electricboy6/STM32U585-devboard/pcb/AT25SF041B-SSHB-B/3D/AT25SF041B-SSHB-B.stp

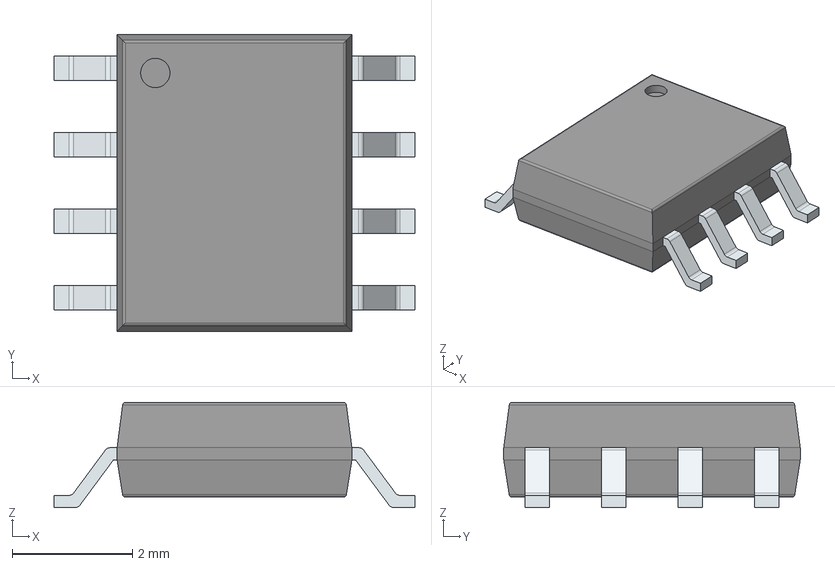
[picture p1: CAD file, 2025-12-07]
pcb/AT25SF041B-SSHB-B/3D/AT25SF041B-SSHB-B.stp
6.00 x 4.92 x 1.75 mm
PinsArrayLR
