electricboy6/STM32U585-devboard/pcb/BLM15AX102SN1D/3D/BLM15AX102SN1D.stp

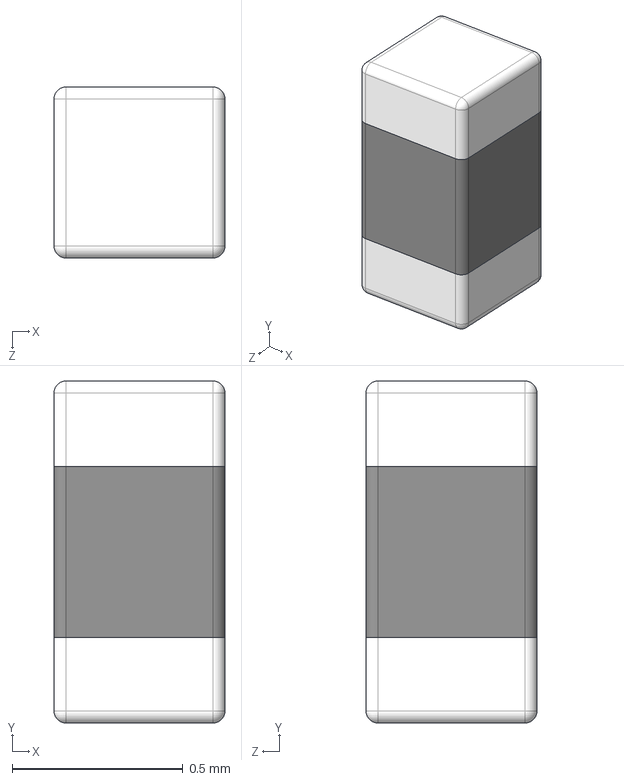
[picture p2: CAD file, 2025-11-30]
pcb/BLM15AX102SN1D/3D/BLM15AX102SN1D.stp
0.5 x 1.00 x 0.5 mm
