electricboy6/STM32U585-devboard/pcb/BMP581/3D/BMP581.stp

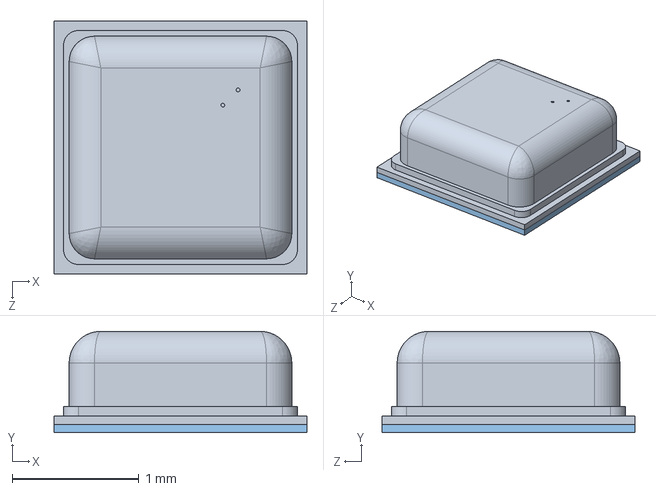
[picture p3: CAD file, 2025-10-23]
pcb/BMP581/3D/BMP581.stp
2.00 x 0.801 x 2.00 mm
