electricboy6/STM32U585-devboard/pcb/CM7V-T1A-32.768KHZ-9PF-10PPM-TA-QC/3D/CM7V-T1A-32.768KHZ-9PF-10PPM-TA-QC.stp

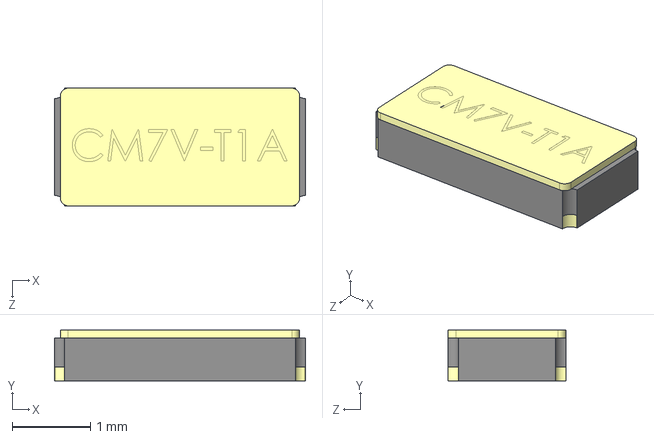
[picture p4: CAD file, 2025-11-30]
pcb/CM7V-T1A-32.768KHZ-9PF-10PPM-TA-QC/3D/CM7V-T1A-32.768KHZ-9PF-10PPM-TA-QC.stp
3.20 x 0.65 x 1.50 mm
