electricboy6/STM32U585-devboard/pcb/ECS-160-8-36B2-CKM-TR/3D/ECS-160-8-36B2-CKM-TR.stp

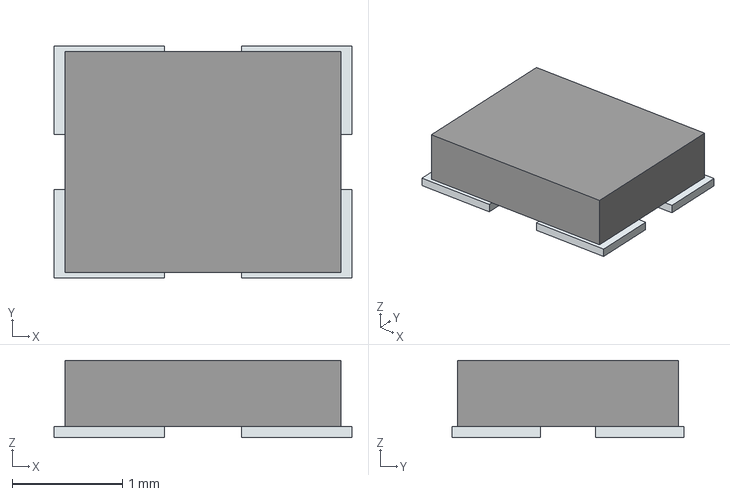
[picture p5: CAD file, 2025-11-26]
pcb/ECS-160-8-36B2-CKM-TR/3D/ECS-160-8-36B2-CKM-TR.stp
2.70 x 2.10 x 0.7 mm
Pins
