electricboy6/STM32U585-devboard/pcb/ECS-TXO-25CSMV-320-AM-TR/3D/ECS-TXO-25CSMV-320-AM-TR.stp

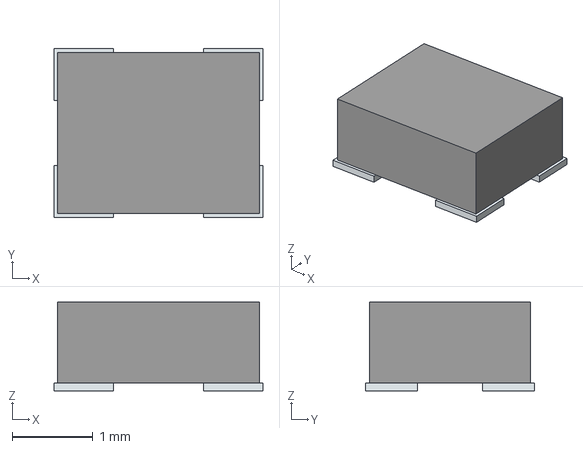
[picture p6: CAD file, 2025-11-10]
pcb/ECS-TXO-25CSMV-320-AM-TR/3D/ECS-TXO-25CSMV-320-AM-TR.stp
2.59 x 2.09 x 1.10 mm
Pins
