electricboy6/STM32U585-devboard/pcb/H3LIS331DLTR/H3LIS331DLTR.step

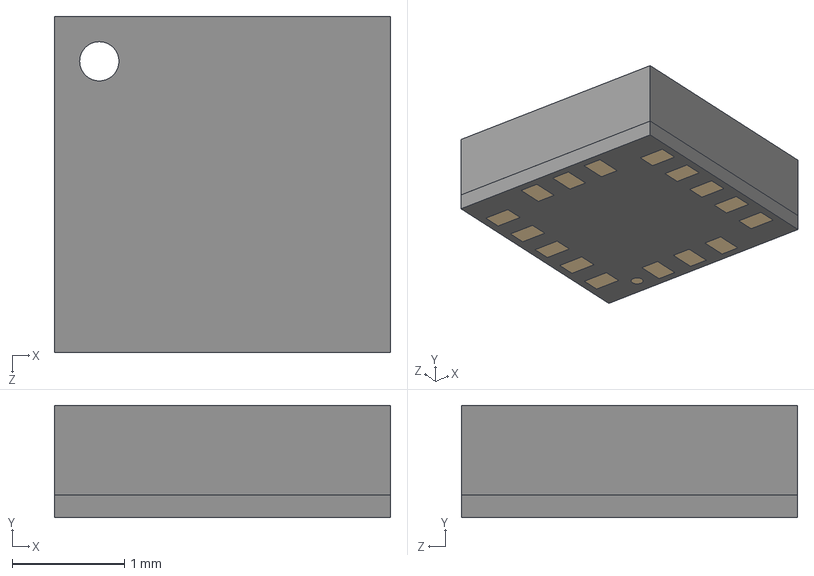
[picture p7: CAD file, 2025-12-19]
pcb/H3LIS331DLTR/H3LIS331DLTR.step
3.00 x 1.00 x 3.00 mm
