electricboy6/STM32U585-devboard/pcb/ICM-42670-P/3D/ICM-42670-P.stp

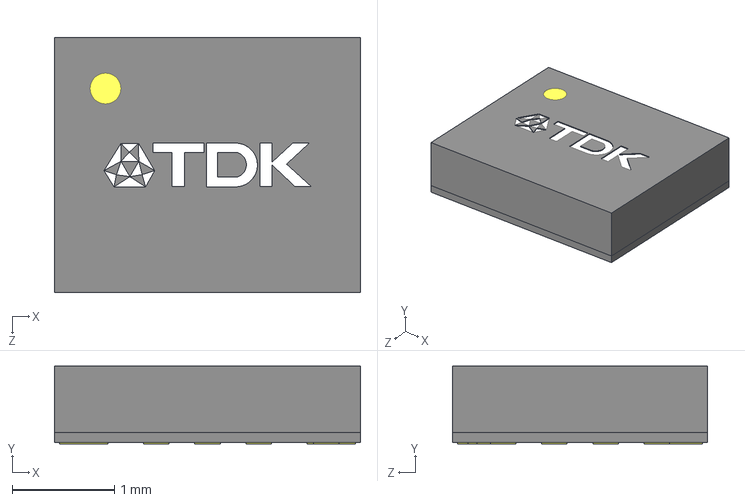
[picture p8: CAD file, 2025-10-23]
pcb/ICM-42670-P/3D/ICM-42670-P.stp
3.00 x 0.76 x 2.50 mm
