electricboy6/STM32U585-devboard/pcb/IRFR9014PBF/3D/IRFR9014PBF.stp

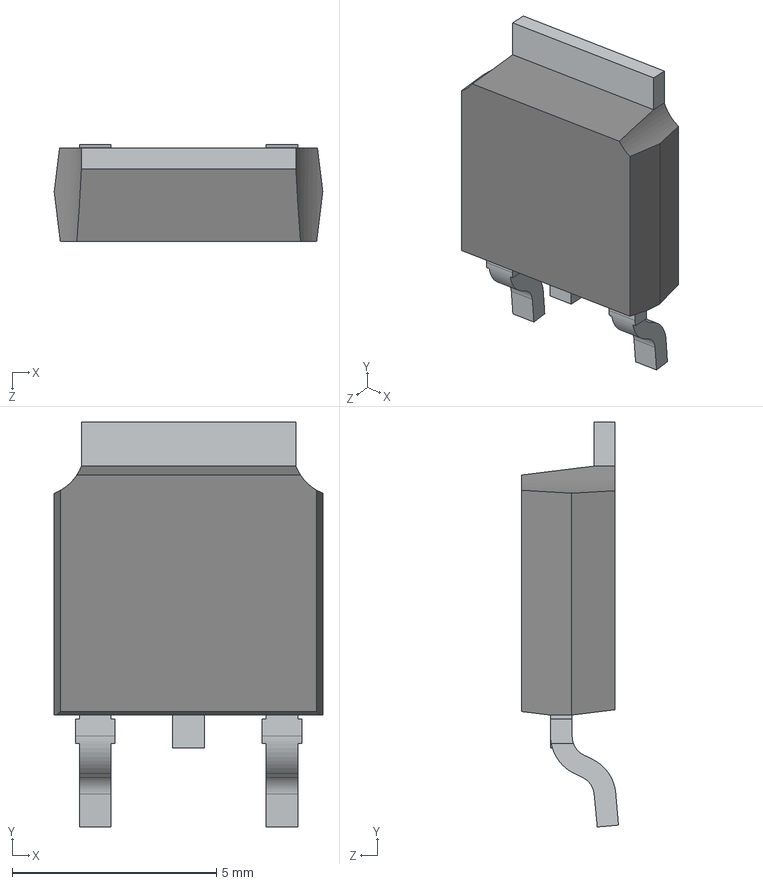
[picture p9: CAD file, 2025-11-10]
pcb/IRFR9014PBF/3D/IRFR9014PBF.stp
6.58 x 9.92 x 2.38 mm
