electricboy6/STM32U585-devboard/pcb/MMC5983MA/3D/MMC5983MA.stp

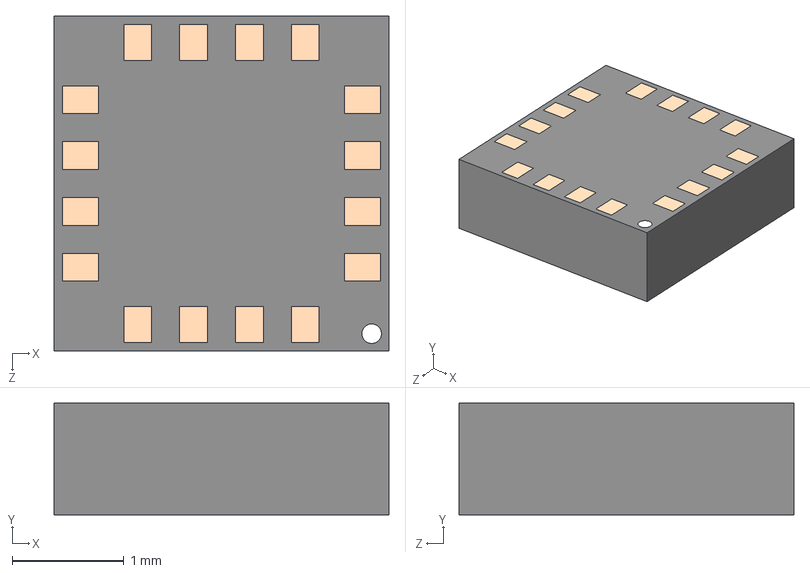
[picture p10: CAD file, 2025-11-10]
pcb/MMC5983MA/3D/MMC5983MA.stp
3.00 x 1.00 x 3.00 mm
