electricboy6/STM32U585-devboard/pcb/MPM3610GQV-Z/3D/MPM3610GQV-Z.stp

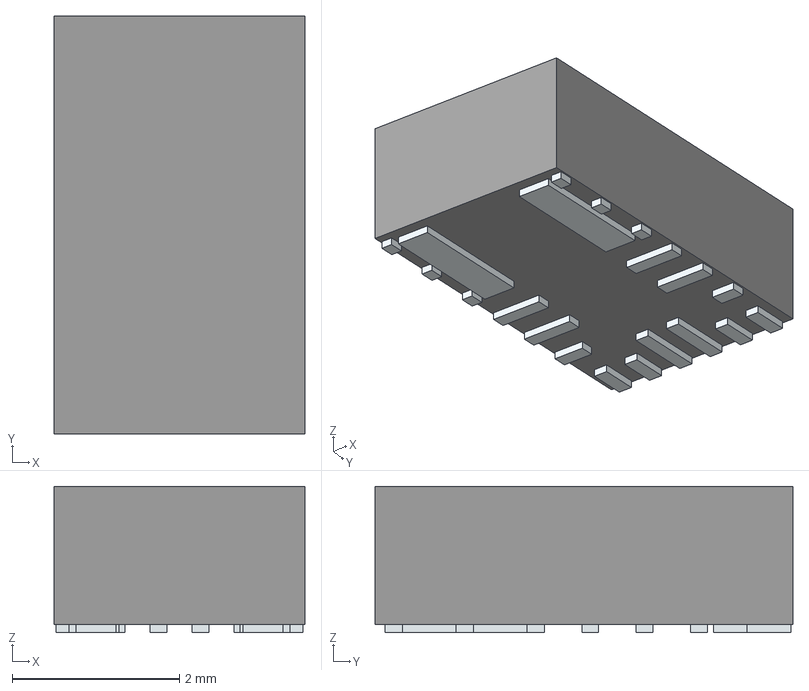
[picture p11: CAD file, 2025-10-26]
pcb/MPM3610GQV-Z/3D/MPM3610GQV-Z.stp
3.00 x 5.00 x 1.75 mm
Pins
