electricboy6/STM32U585-devboard/pcb/partsLibs/TBC05-02-1-G-G/3D/TBC05-02-1-G-G.stp

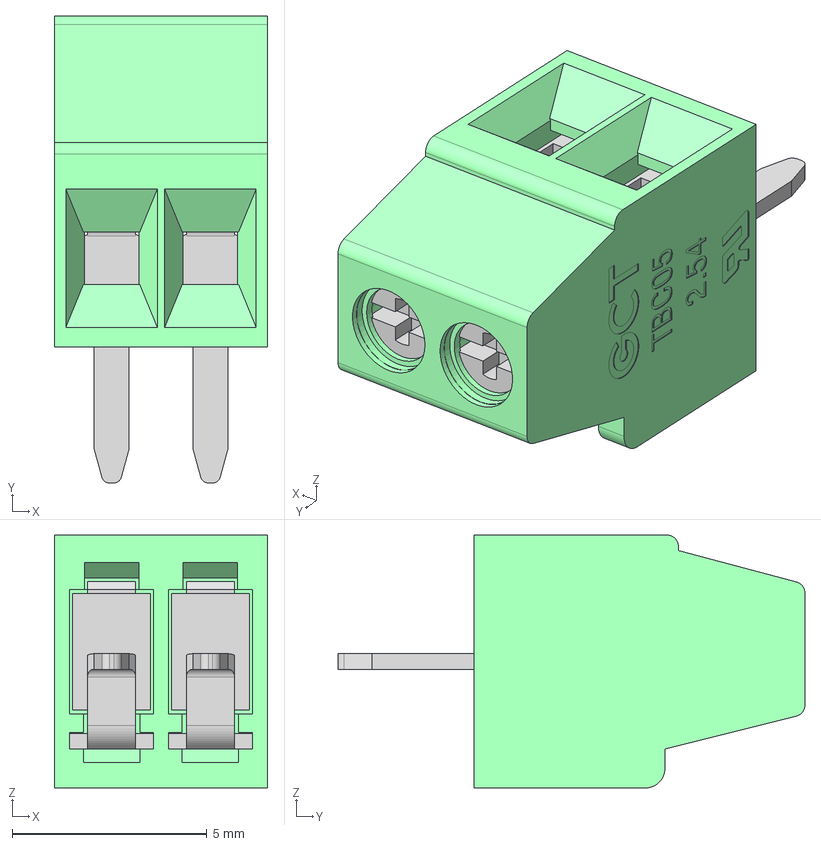
[picture p12: CAD file, 2025-12-23]
pcb/partsLibs/TBC05-02-1-G-G/3D/TBC05-02-1-G-G.stp
5.48 x 12.0 x 6.50 mm
TBC05-02-1-G-G_H
TBC05-02-1-G-G_P x 2
