electricboy6/STM32U585-devboard/pcb/partsLibs/TBC05-04-1-G-G/3D/TBC05-04-1-G-G.stp

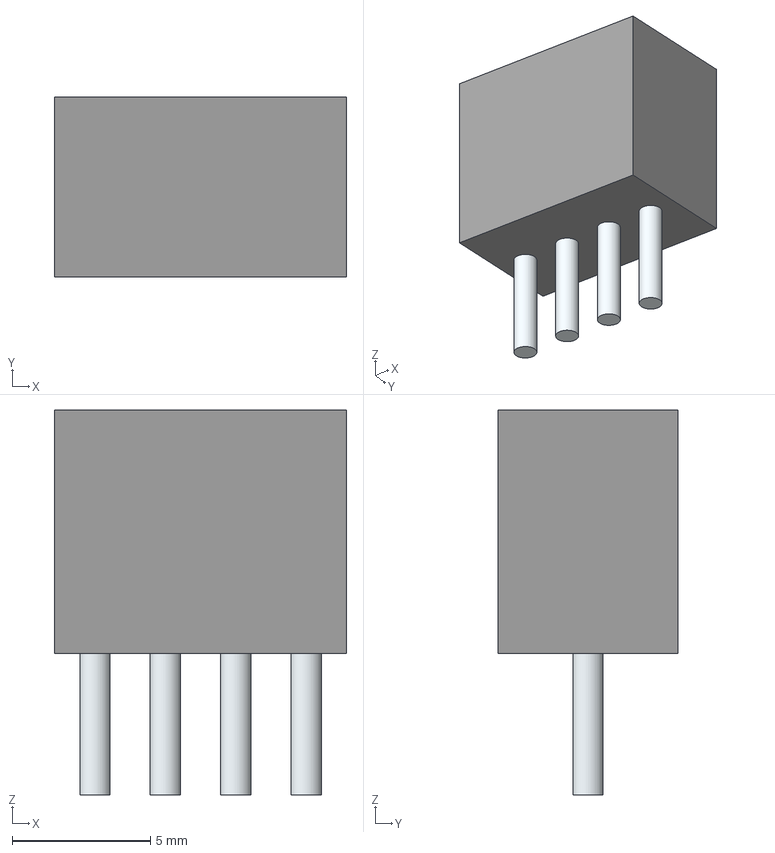
[picture p13: CAD file, 2025-12-23]
pcb/partsLibs/TBC05-04-1-G-G/3D/TBC05-04-1-G-G.stp
10.6 x 6.50 x 13.9 mm
Leads
