electricboy6/STM32U585-devboard/pcb/partsLibs/TBC05-06-1-G-G/3D/TBC05-06-1-G-G.stp

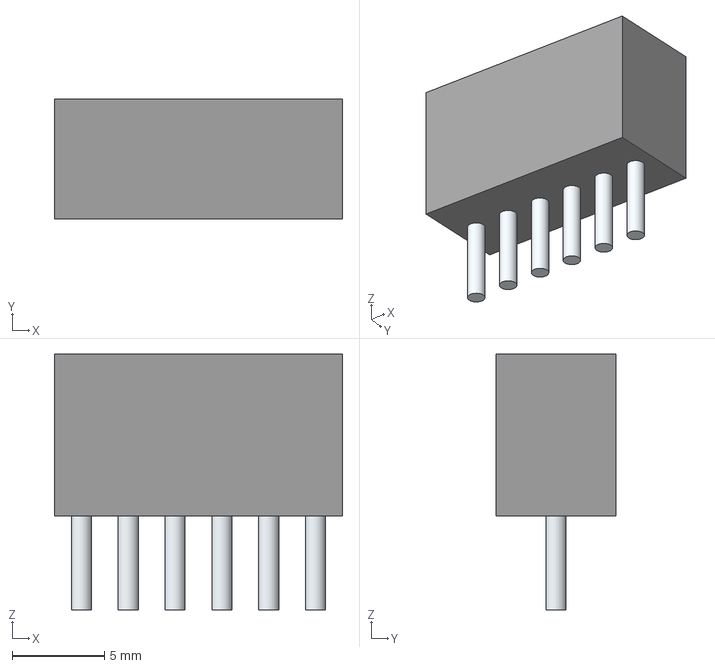
[picture p14: CAD file, 2025-12-23]
pcb/partsLibs/TBC05-06-1-G-G/3D/TBC05-06-1-G-G.stp
15.6 x 6.50 x 13.9 mm
Leads
