electricboy6/STM32U585-devboard/pcb/PS1240P02BT/3D/PS1240P02BT.stp

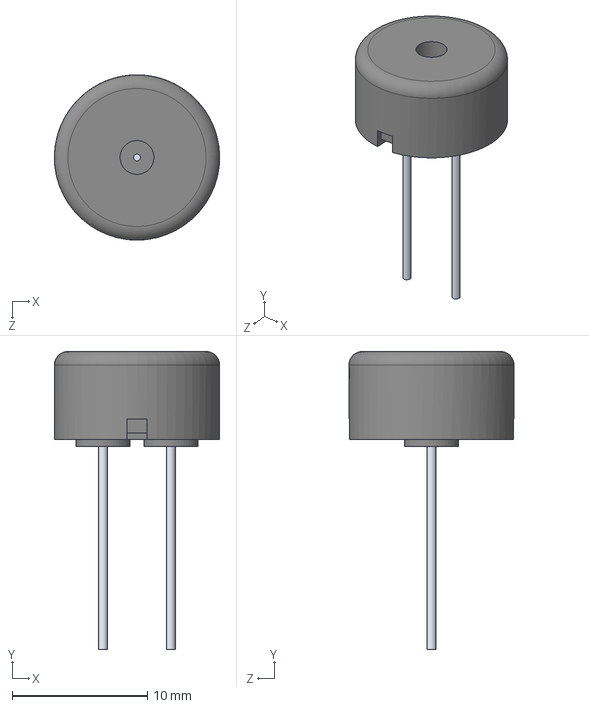
[picture p15: CAD file, 2025-12-08]
pcb/PS1240P02BT/3D/PS1240P02BT.stp
12.2 x 22.0 x 12.2 mm
