electricboy6/STM32U585-devboard/pcb/3dmodels/tbc05-06-1-g-g.stp

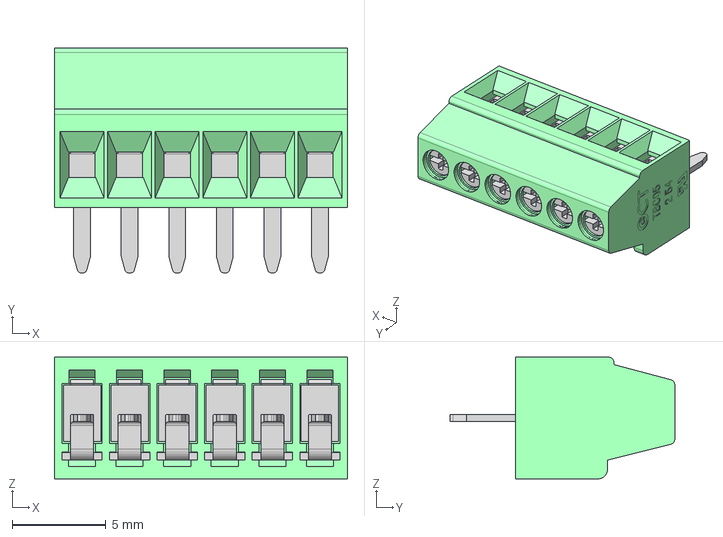
[picture p17: CAD file, 2025-12-27]
pcb/3dmodels/tbc05-06-1-g-g.stp
15.6 x 12.0 x 6.50 mm
