electricboy6/STM32U585-devboard/pcb/3dmodels/stm32u073.step

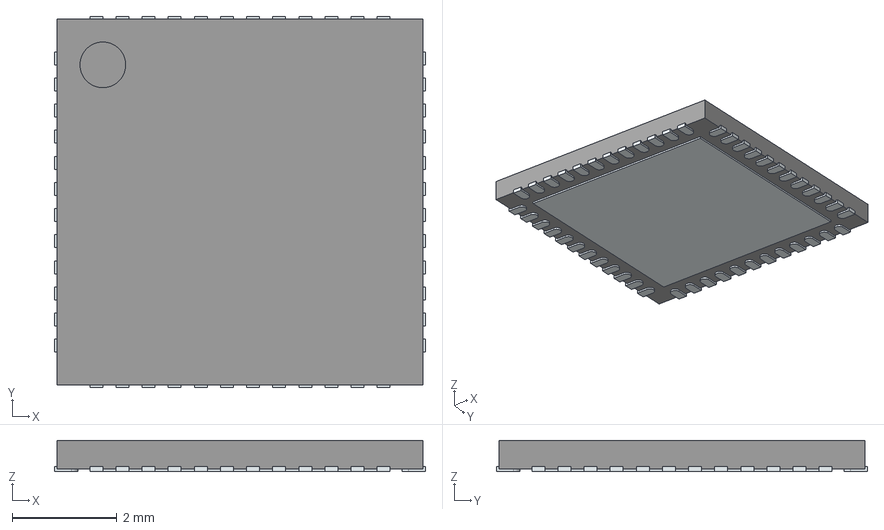
[picture p18: CAD file, 2025-12-21]
pcb/3dmodels/stm32u073.step
7.10 x 7.10 x 0.6 mm
ThermalPin
PinsArrayLR
PinsArrayTB
