electricboy6/STM32U585-devboard/pcb/3dmodels/MAX-M10S-00B.STEP

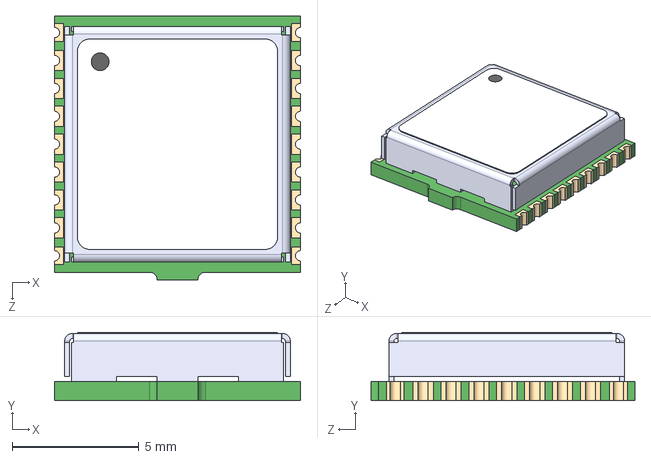
[picture p19: CAD file, 2025-12-21]
pcb/3dmodels/MAX-M10S-00B.STEP
9.70 x 2.70 x 10.4 mm
