electricboy6/STM32U585-devboard/pcb/3dmodels/stm32u585.step

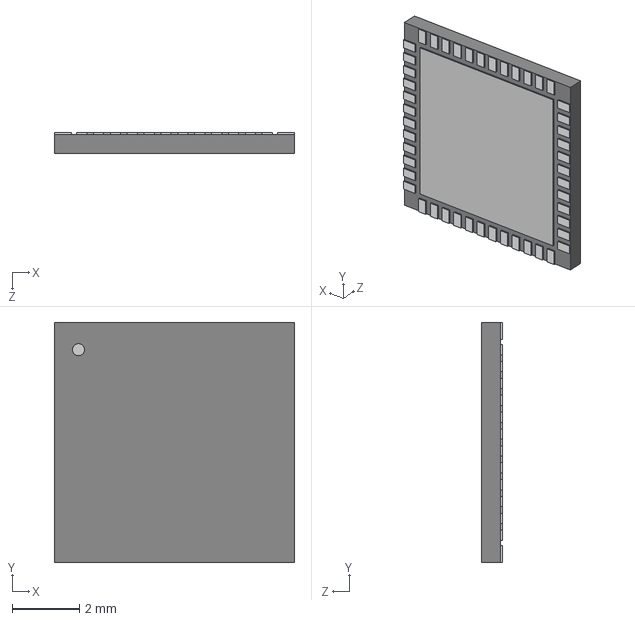
[picture p20: CAD file, 2025-12-21]
pcb/3dmodels/stm32u585.step
7.11 x 7.11 x 0.612 mm
