electricboy6/STM32U585-devboard/(list of files, cad)

Other CAD files:
pcb/3dmodels/1040310811.stp
pcb/73412-0114/3D/73412-0114.stp
