electricboy6/STM32U585-devboard/pcb/stDevboard.kicad_pcb

## KiCad design pcb/stDevboard.kicad_pcb (2026-01-02)

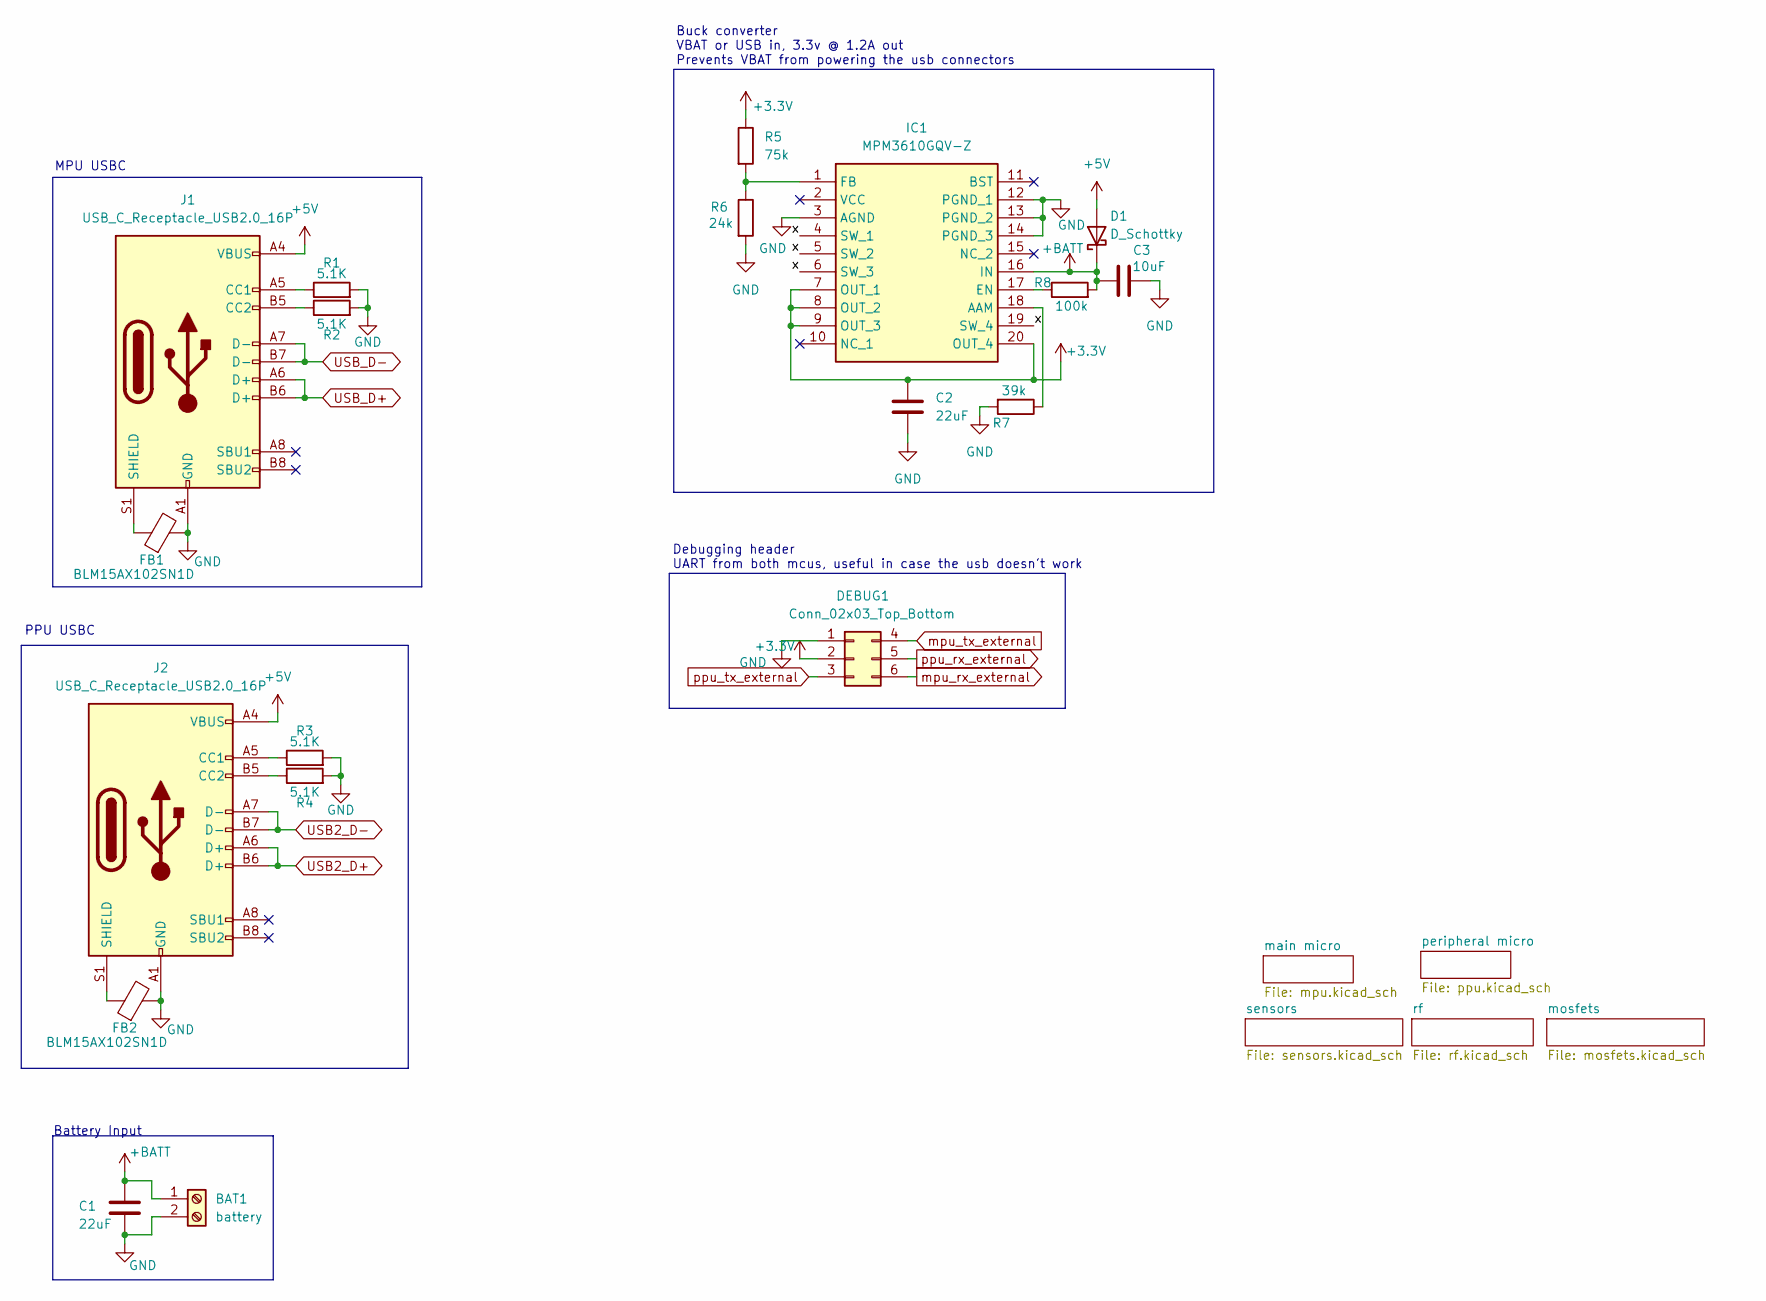
[picture p21: schematic stDevboard.kicad_sch]

Parts:
BAT1: battery; TBC05021GG
C1, C2: 22uF; C_0603_1608Metric
C3: 10uF; C_0603_1608Metric
D1: D_Schottky; D_SOD-123
DEBUG1: Conn_02x03_Top_Bottom; PinHeader_2x03_P2.54mm_Vertical
FB1, FB2: BLM15AX102SN1D; NFZ15SG152SN10B
IC1: MPM3610GQV-Z; MPM3606GQVZ; Mouser Part Number 946-MPM3610GQV-Z
J1, J2: USB_C_Receptacle_USB2.0_16P; USB_C_Receptacle_GCT_USB4085
R1, R2, R3, R4: 5.1K; R_0402_1005Metric
R5: 75k; R_0402_1005Metric
R6: 24k; R_0402_1005Metric
R7: 39k; R_0402_1005Metric
R8: 100k; R_0402_1005Metric

Connections:
+5V: D1.2 (A), J1.A4 (VBUS), J1.A9 (VBUS), J1.B4 (VBUS), J1.B9 (VBUS), J2.A4 (VBUS), J2.A9 (VBUS), J2.B4 (VBUS), J2.B9 (VBUS)
+BATT: BAT1.1, C1.1, C3.1, D1.1 (K), IC1.16 (IN), R8.2; also elsewhere on the board
/x: IC1.4 (SW_1), IC1.5 (SW_2), IC1.6 (SW_3), IC1.19 (SW_4)
GND: BAT1.2, C1.2, C2.1, C3.2, DEBUG1.1, FB1.2, FB2.2, IC1.3 (AGND), IC1.12 (PGND_1), IC1.13 (PGND_2), IC1.14 (PGND_3), J1.A1 (GND), J1.A12 (GND), J1.B1 (GND), J1.B12 (GND), J2.A1 (GND), J2.A12 (GND), J2.B1 (GND), J2.B12 (GND), R1.2, R2.2, R3.2, R4.2, R6.2, R7.2; also elsewhere on the board
unnamed: IC1.18 (AAM), R7.1
unnamed: IC1.17 (EN), R8.1
unnamed: IC1.1 (FB), R5.2, R6.1
unnamed: J1.A5 (CC1), R1.1
unnamed: J1.B5 (CC2), R2.1
unnamed: FB1.1, J1.S1 (SHIELD)
unnamed: J2.A5 (CC1), R3.1
unnamed: J2.B5 (CC2), R4.1
unnamed: FB2.1, J2.S1 (SHIELD)
USB2_D+: J2.A6 (D+), J2.B6 (D+); also elsewhere on the board
USB2_D-: J2.A7 (D-), J2.B7 (D-); also elsewhere on the board
USB_D+: J1.A6 (D+), J1.B6 (D+); also elsewhere on the board
USB_D-: J1.A7 (D-), J1.B7 (D-); also elsewhere on the board
mpu_rx_external: DEBUG1.6; also elsewhere on the board
mpu_tx_external: DEBUG1.4; also elsewhere on the board
ppu_rx_external: DEBUG1.5; also elsewhere on the board
ppu_tx_external: DEBUG1.3; also elsewhere on the board

Notes on the sheet:
Debugging header UART from both mcus, useful in case the usb doesn't work
Buck converter VBAT or USB in, 3.3v @ 1.2A out Prevents VBAT from powering the usb connectors
MPU USBC
PPU USBC
Battery Input

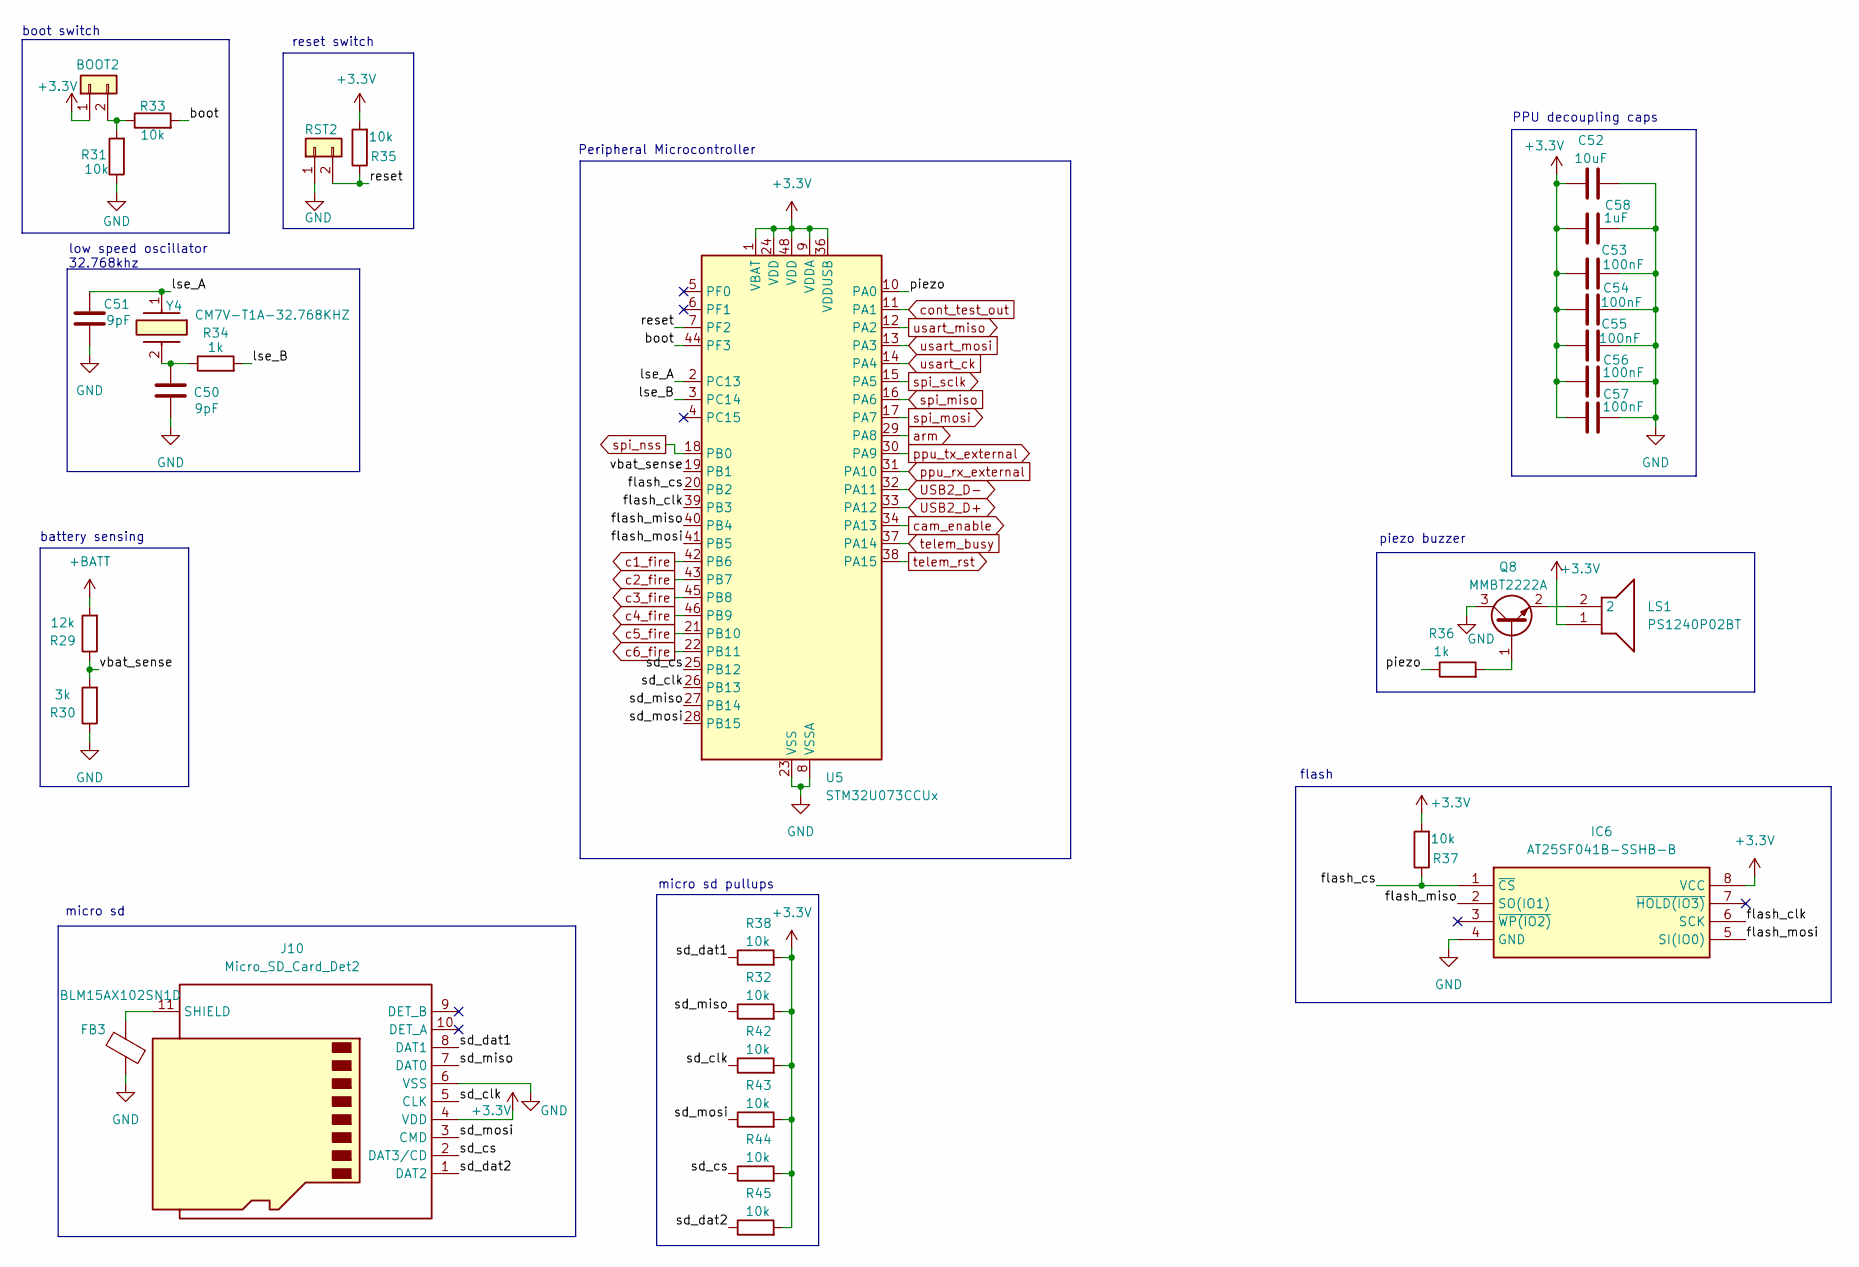
[picture p22: schematic ppu.kicad_sch]

Parts:
BOOT2: Conn_01x02; PinHeader_1x02_P2.54mm_Vertical
C50, C51: 9pF; C_0402_1005Metric
C52: 10uF; C_0603_1608Metric
C53, C54, C55, C56, C57: 100nF; C_0402_1005Metric
C58: 1uF; C_0603_1608Metric
FB3: BLM15AX102SN1D; NFZ15SG152SN10B
IC6: AT25SF041B-SSHB-B; SOIC127P600X175-8N; Mouser Part Number 988-AT25SF041-SSH-B
J10: Micro_SD_Card_Det2; microSD_HC_Molex_104031-0811
LS1: PS1240P02BT; Mouser Part Number 810-PS1240P02BT
Q8: MMBT2222A; SOT-23
R29: 12k; R_0402_1005Metric
R30: 3k; R_0402_1005Metric
R31, R32, R33, R35, R37, R38, R42, R43, R44, R45: 10k; R_0402_1005Metric
R34, R36: 1k; R_0402_1005Metric
RST2: Conn_01x02; PinHeader_1x02_P2.54mm_Vertical
U5: STM32U073CCUx; QFN-48-1EP_7x7mm_P0.5mm_EP5.6x5.6mm
Y4: CM7V-T1A-32.768KHZ; CM7V32768TBQA020; Mouser Part Number 428-201565-MG01

Connections:
+BATT: R29.2; also elsewhere on the board
/peripheral micro/boot: R33.2, U5.44 (PF3)
/peripheral micro/flash_clk: IC6.6 (SCK), U5.39 (PB3)
/peripheral micro/flash_cs: IC6.1 (~CS), R37.1, U5.20 (PB2)
/peripheral micro/flash_miso: IC6.2 (SO(IO1)), U5.40 (PB4)
/peripheral micro/flash_mosi: IC6.5 (SI(IO0)), U5.41 (PB5)
/peripheral micro/lse_A: C51.1, U5.2 (PC13), Y4.1
/peripheral micro/lse_B: R34.2, U5.3 (PC14)
/peripheral micro/piezo: R36.1, U5.10 (PA0)
/peripheral micro/reset: R35.1, RST2.2, U5.7 (PF2)
/peripheral micro/sd_clk: J10.5 (CLK), R42.1, U5.26 (PB13)
/peripheral micro/sd_dat1: J10.8 (DAT1), R38.1
/peripheral micro/sd_dat2: J10.1 (DAT2), R45.1
/peripheral micro/sd_mosi: J10.3 (CMD), R43.1, U5.28 (PB15)
/peripheral micro/vbat_sense: R29.1, R30.2, U5.19 (PB1)
GND: C50.2, C51.2, C52.2, C53.2, C54.1, C55.1, C56.1, C57.2, C58.2, FB3.1, IC6.4 (GND), J10.6 (VSS), Q8.3 (C), R30.1, R31.1, RST2.1, U5.8 (VSSA), U5.23 (VSS), U5.35 (VSS), U5.47 (VSS), U5.49 (VSS); also elsewhere on the board
unnamed: BOOT2.2, R31.2, R33.1
unnamed: C50.1, R34.1, Y4.2
unnamed: FB3.2, J10.11 (SHIELD)
unnamed: Q8.1 (B), R36.2
unnamed: LS1.2, Q8.2 (E)
USB2_D+: U5.33 (PA12); also elsewhere on the board
USB2_D-: U5.32 (PA11); also elsewhere on the board
arm: U5.29 (PA8); also elsewhere on the board
c1_fire: U5.42 (PB6); also elsewhere on the board
c2_fire: U5.43 (PB7); also elsewhere on the board
c3_fire: U5.45 (PB8); also elsewhere on the board
c4_fire: U5.46 (PB9); also elsewhere on the board
c5_fire: U5.21 (PB10); also elsewhere on the board
c6_fire: U5.22 (PB11); also elsewhere on the board
cam_enable: U5.34 (PA13); also elsewhere on the board
cont_test_out: U5.11 (PA1); also elsewhere on the board
ppu_rx_external: U5.31 (PA10); also elsewhere on the board
ppu_tx_external: U5.30 (PA9); also elsewhere on the board
spi_miso: U5.16 (PA6); also elsewhere on the board
spi_mosi: U5.17 (PA7); also elsewhere on the board
spi_nss: U5.18 (PB0); also elsewhere on the board
spi_sclk: U5.15 (PA5); also elsewhere on the board
telem_busy: U5.37 (PA14); also elsewhere on the board
telem_rst: U5.38 (PA15); also elsewhere on the board
usart_ck: U5.14 (PA4); also elsewhere on the board
usart_miso: U5.12 (PA2); also elsewhere on the board
usart_mosi: U5.13 (PA3); also elsewhere on the board

Notes on the sheet:
flash
PPU decoupling caps
reset switch
battery sensing
Peripheral Microcontroller
boot switch
micro sd
piezo buzzer
low speed oscillator 32.768khz
micro sd pullups

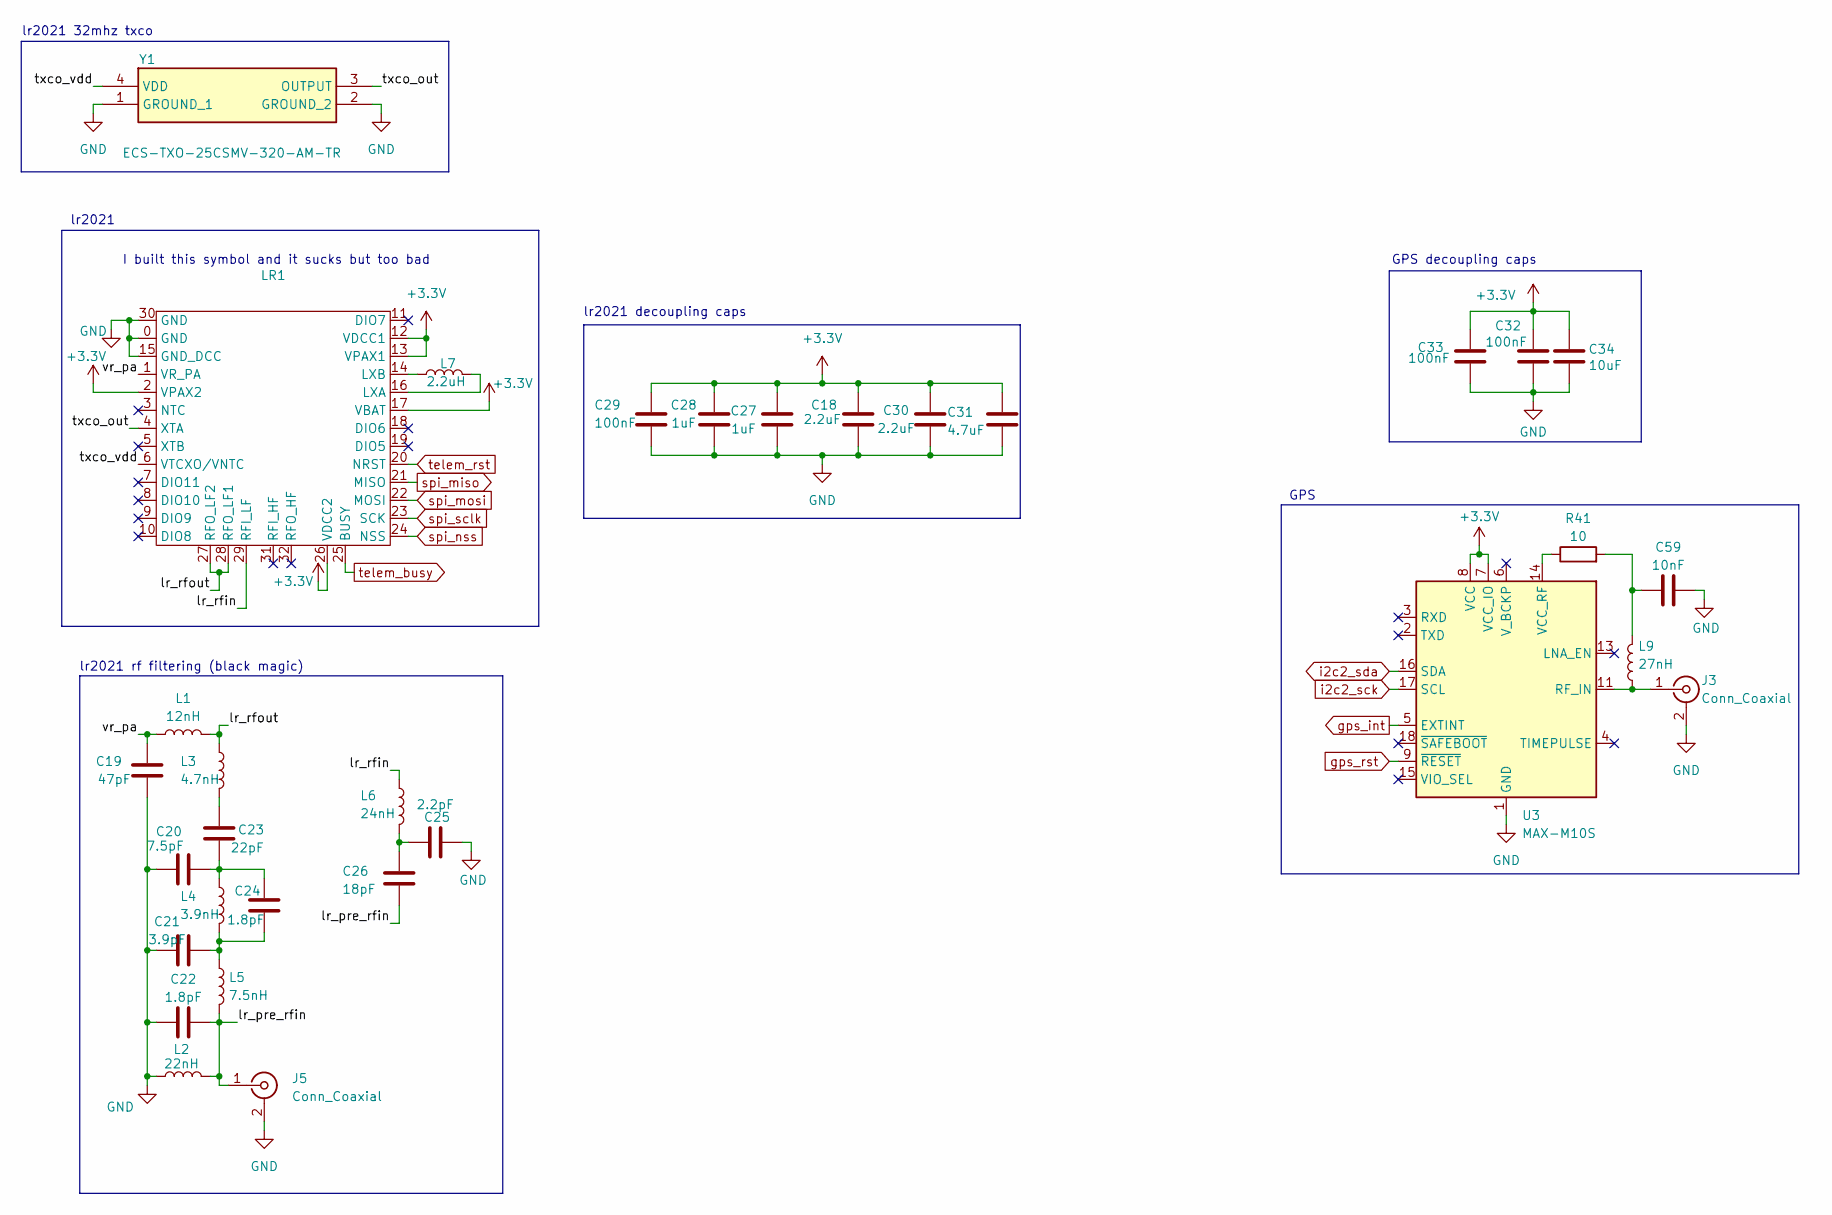
[picture p23: schematic rf.kicad_sch]

Parts:
C18, C30: 2.2uF; C_0603_1608Metric
C19: 47pF; C_0402_1005Metric
C20: 7.5pF; C_0402_1005Metric
C21: 3.9pF; C_0402_1005Metric
C22, C24: 1.8pF; C_0402_1005Metric
C23: 22pF; C_0402_1005Metric
C25: 2.2pF; C_0402_1005Metric
C26: 18pF; C_0402_1005Metric
C27, C28: 1uF; C_0603_1608Metric
C29, C32, C33: 100nF; C_0402_1005Metric
C31: 4.7uF; C_0603_1608Metric
C34: 10uF; C_0603_1608Metric
C59: 10nF; C_0402_1005Metric
J3, J5: Conn_Coaxial; U.FL_Hirose_U.FL-R-SMT-1_Vertical
L1: 12nH; L_0603_1608Metric
L2: 22nH; L_0402_1005Metric
L3: 4.7nH; L_0402_1005Metric
L4: 3.9nH; L_0402_1005Metric
L5: 7.5nH; L_0402_1005Metric
L6: 24nH; L_0402_1005Metric
L7: 2.2uH; L_0603_1608Metric
L9: 27nH; L_0402_1005Metric
LR1: LR2021
R41: 10; R_0603_1608Metric
U3: MAX-M10S; ublox_MAX
Y1: ECS-TXO-25CSMV-320-AM-TR; ECSTXO25CSMV320AMTR; Mouser Part Number 520-TXO25CSMV320AMTR

Connections:
/rf/lr_pre_rfin: C22.2, C26.2, J5.1 (In), L2.2, L5.2
/rf/lr_rfin: L6.1, LR1.29 (RFI_LF)
/rf/lr_rfout: L1.2, L3.1, LR1.27 (RFO_LF2), LR1.28 (RFO_LF1)
/rf/txco_out: LR1.4 (XTA), Y1.3 (OUTPUT)
/rf/txco_vdd: LR1.6 (VTCXO/VNTC), Y1.4 (VDD)
/rf/vr_pa: C19.1, L1.1, LR1.1 (VR_PA)
GND: C18.1, C19.2, C20.1, C21.1, C22.1, C25.2, C27.2, C28.1, C29.2, C30.1, C31.2, C32.1, C33.2, C34.2, C59.2, J3.2 (Ext), J5.2 (Ext), L2.1, LR1.0 (GND), LR1.15 (GND_DCC), LR1.30 (GND), U3.1 (GND), U3.10 (GND), U3.12 (GND), Y1.1 (GROUND_1), Y1.2 (GROUND_2); also elsewhere on the board
unnamed: C20.2, C23.2, C24.1, L4.1
unnamed: C21.2, C24.2, L4.2, L5.1
unnamed: C23.1, L3.2
unnamed: C25.1, C26.1, L6.2
unnamed: C59.1, L9.2, R41.2
unnamed: J3.1 (In), L9.1, U3.11 (RF_IN)
unnamed: L7.2, LR1.16 (LXA)
unnamed: L7.1, LR1.14 (LXB)
unnamed: R41.1, U3.14 (VCC_RF)
gps_int: U3.5 (EXTINT); also elsewhere on the board
gps_rst: U3.9 (~RESET); also elsewhere on the board
i2c2_sck: U3.17 (SCL); also elsewhere on the board
i2c2_sda: U3.16 (SDA); also elsewhere on the board
spi_miso: LR1.21 (MISO); also elsewhere on the board
spi_mosi: LR1.22 (MOSI); also elsewhere on the board
spi_nss: LR1.24 (NSS); also elsewhere on the board
spi_sclk: LR1.23 (SCK); also elsewhere on the board
telem_busy: LR1.25 (BUSY); also elsewhere on the board
telem_rst: LR1.20 (NRST); also elsewhere on the board

Notes on the sheet:
lr2021 32mhz txco
GPS decoupling caps
lr2021
lr2021 rf filtering (black magic)
GPS
I built this symbol and it sucks but too bad
lr2021 decoupling caps

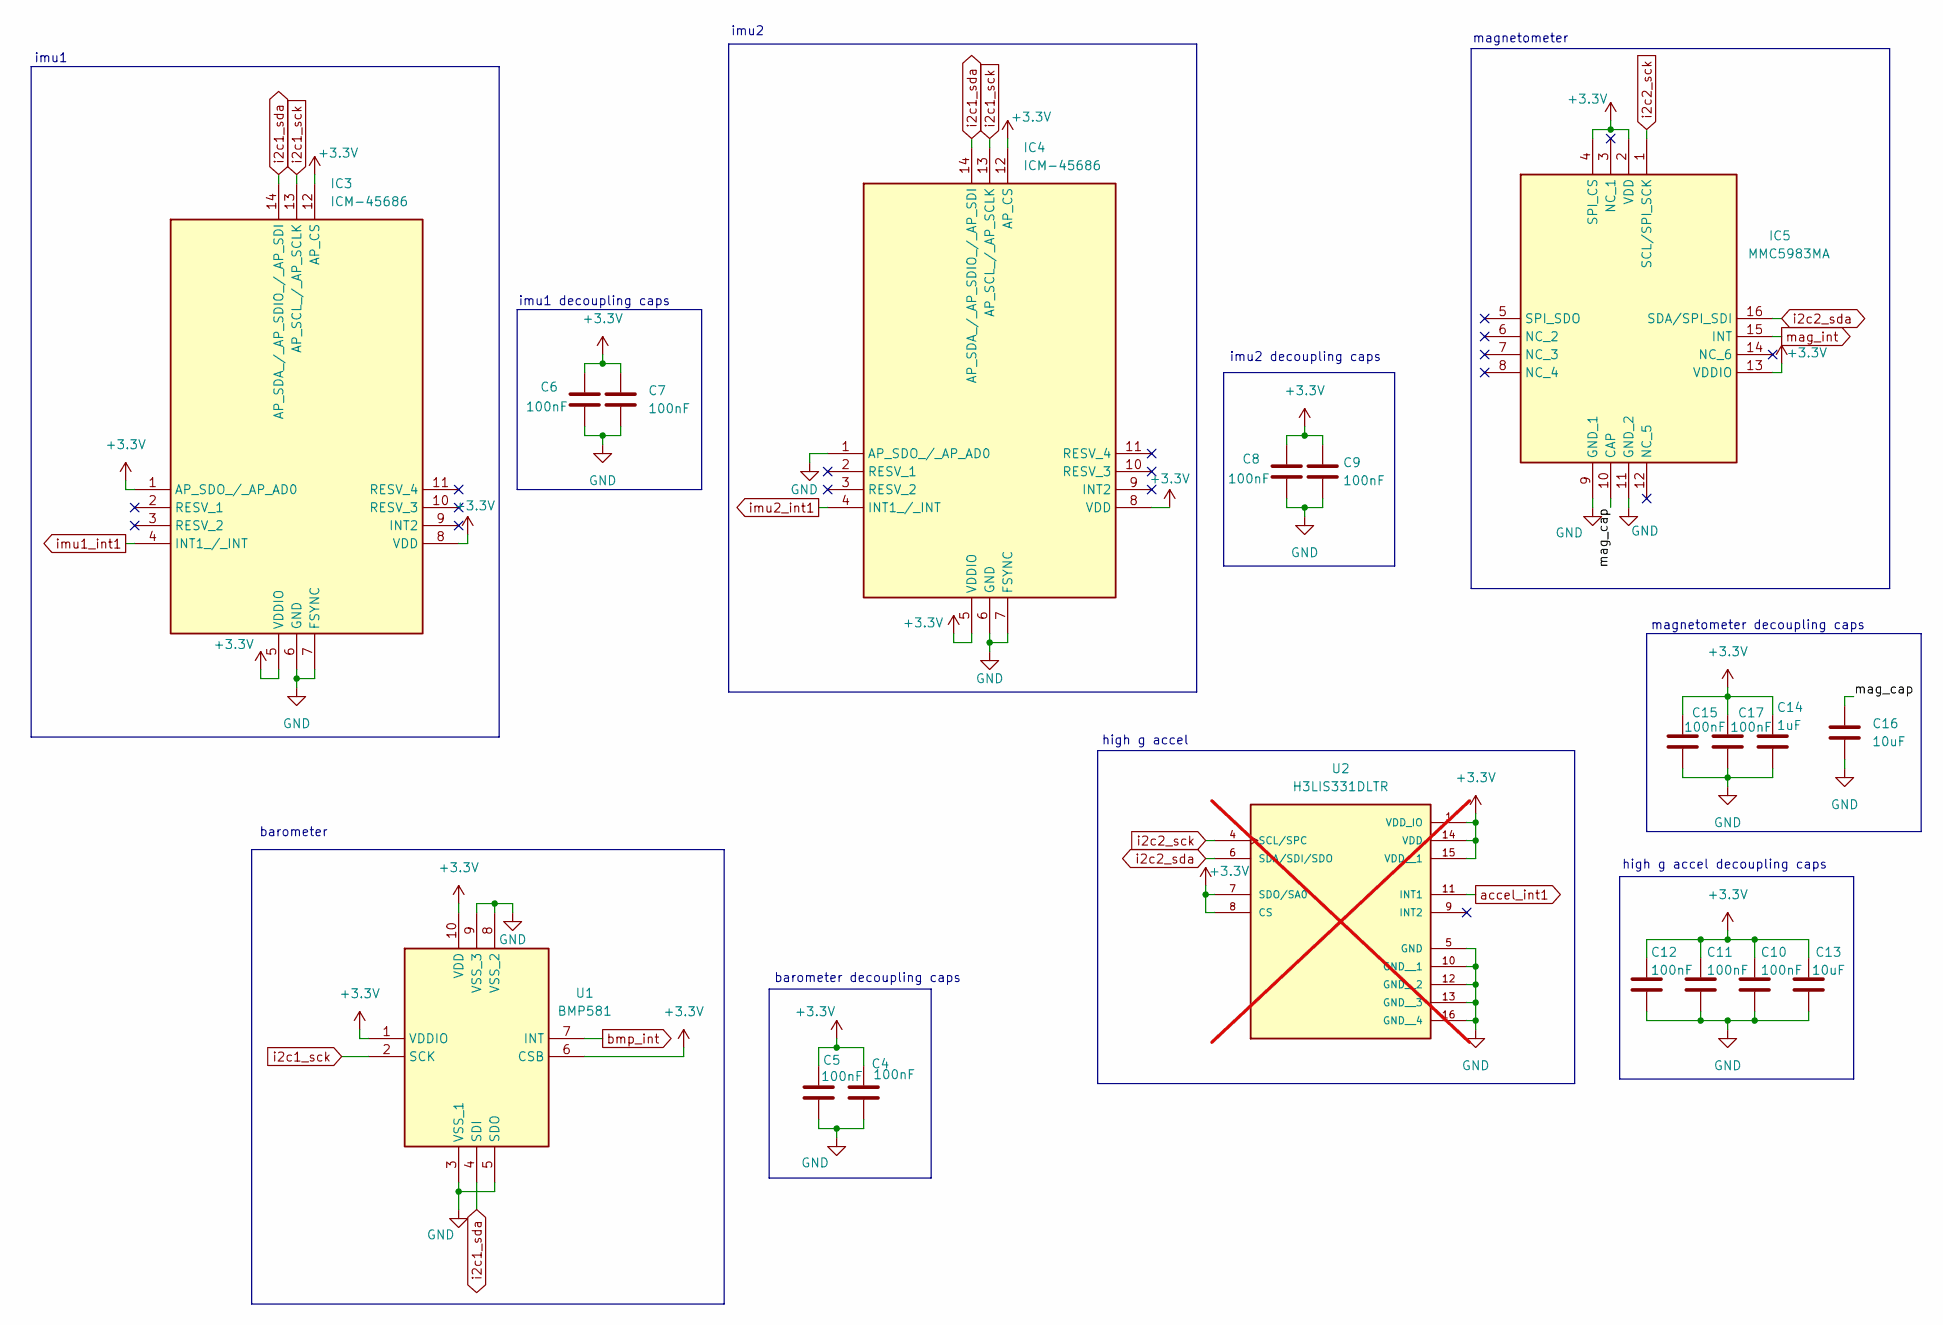
[picture p24: schematic sensors.kicad_sch]

Parts:
C4, C5, C6, C7, C8, C9, C10, C11, C12, C15, C17: 100nF; C_0402_1005Metric
C13, C16: 10uF; C_0603_1608Metric
C14: 1uF; C_0603_1608Metric
IC3, IC4: ICM-45686; ICM42670P; Mouser Part Number 410-ICM-42670-P
IC5: MMC5983MA; Mouser Part Number 438-MMC5983MA
U1: BMP581; Mouser Part Number 262-BMP581
U2: H3LIS331DLTR; QFN300X300X100-16N; not fitted

Connections:
/sensors/mag_cap: C16.1, IC5.10 (CAP)
GND: C4.1, C5.1, C6.2, C7.2, C8.2, C9.2, C10.1, C11.1, C12.1, C13.1, C14.1, C15.1, C16.2, C17.1, IC3.6 (GND), IC3.7 (FSYNC), IC4.1 (AP_SDO_/_AP_AD0), IC4.6 (GND), IC4.7 (FSYNC), IC5.9 (GND_1), IC5.11 (GND_2), U1.3 (VSS_1), U1.5 (SDO), U1.8 (VSS_2), U1.9 (VSS_3), U2.5 (GND), U2.10 (GND__1), U2.12 (GND__2), U2.13 (GND__3), U2.16 (GND__4); also elsewhere on the board
accel_int1: U2.11 (INT1); also elsewhere on the board
bmp_int: U1.7 (INT); also elsewhere on the board
i2c1_sck: IC3.13 (AP_SCL_/_AP_SCLK), IC4.13 (AP_SCL_/_AP_SCLK), U1.2 (SCK); also elsewhere on the board
i2c1_sda: IC3.14 (AP_SDA_/_AP_SDIO_/_AP_SDI), IC4.14 (AP_SDA_/_AP_SDIO_/_AP_SDI), U1.4 (SDI); also elsewhere on the board
i2c2_sck: IC5.1 (SCL/SPI_SCK), U2.4 (SCL/SPC); also elsewhere on the board
i2c2_sda: IC5.16 (SDA/SPI_SDI), U2.6 (SDA/SDI/SDO); also elsewhere on the board
imu1_int1: IC3.4 (INT1_/_INT); also elsewhere on the board
imu2_int1: IC4.4 (INT1_/_INT); also elsewhere on the board
mag_int: IC5.15 (INT); also elsewhere on the board

Notes on the sheet:
high g accel
imu1 decoupling caps
magnetometer
high g accel decoupling caps
barometer decoupling caps
barometer
imu1
magnetometer decoupling caps
imu2 decoupling caps
imu2

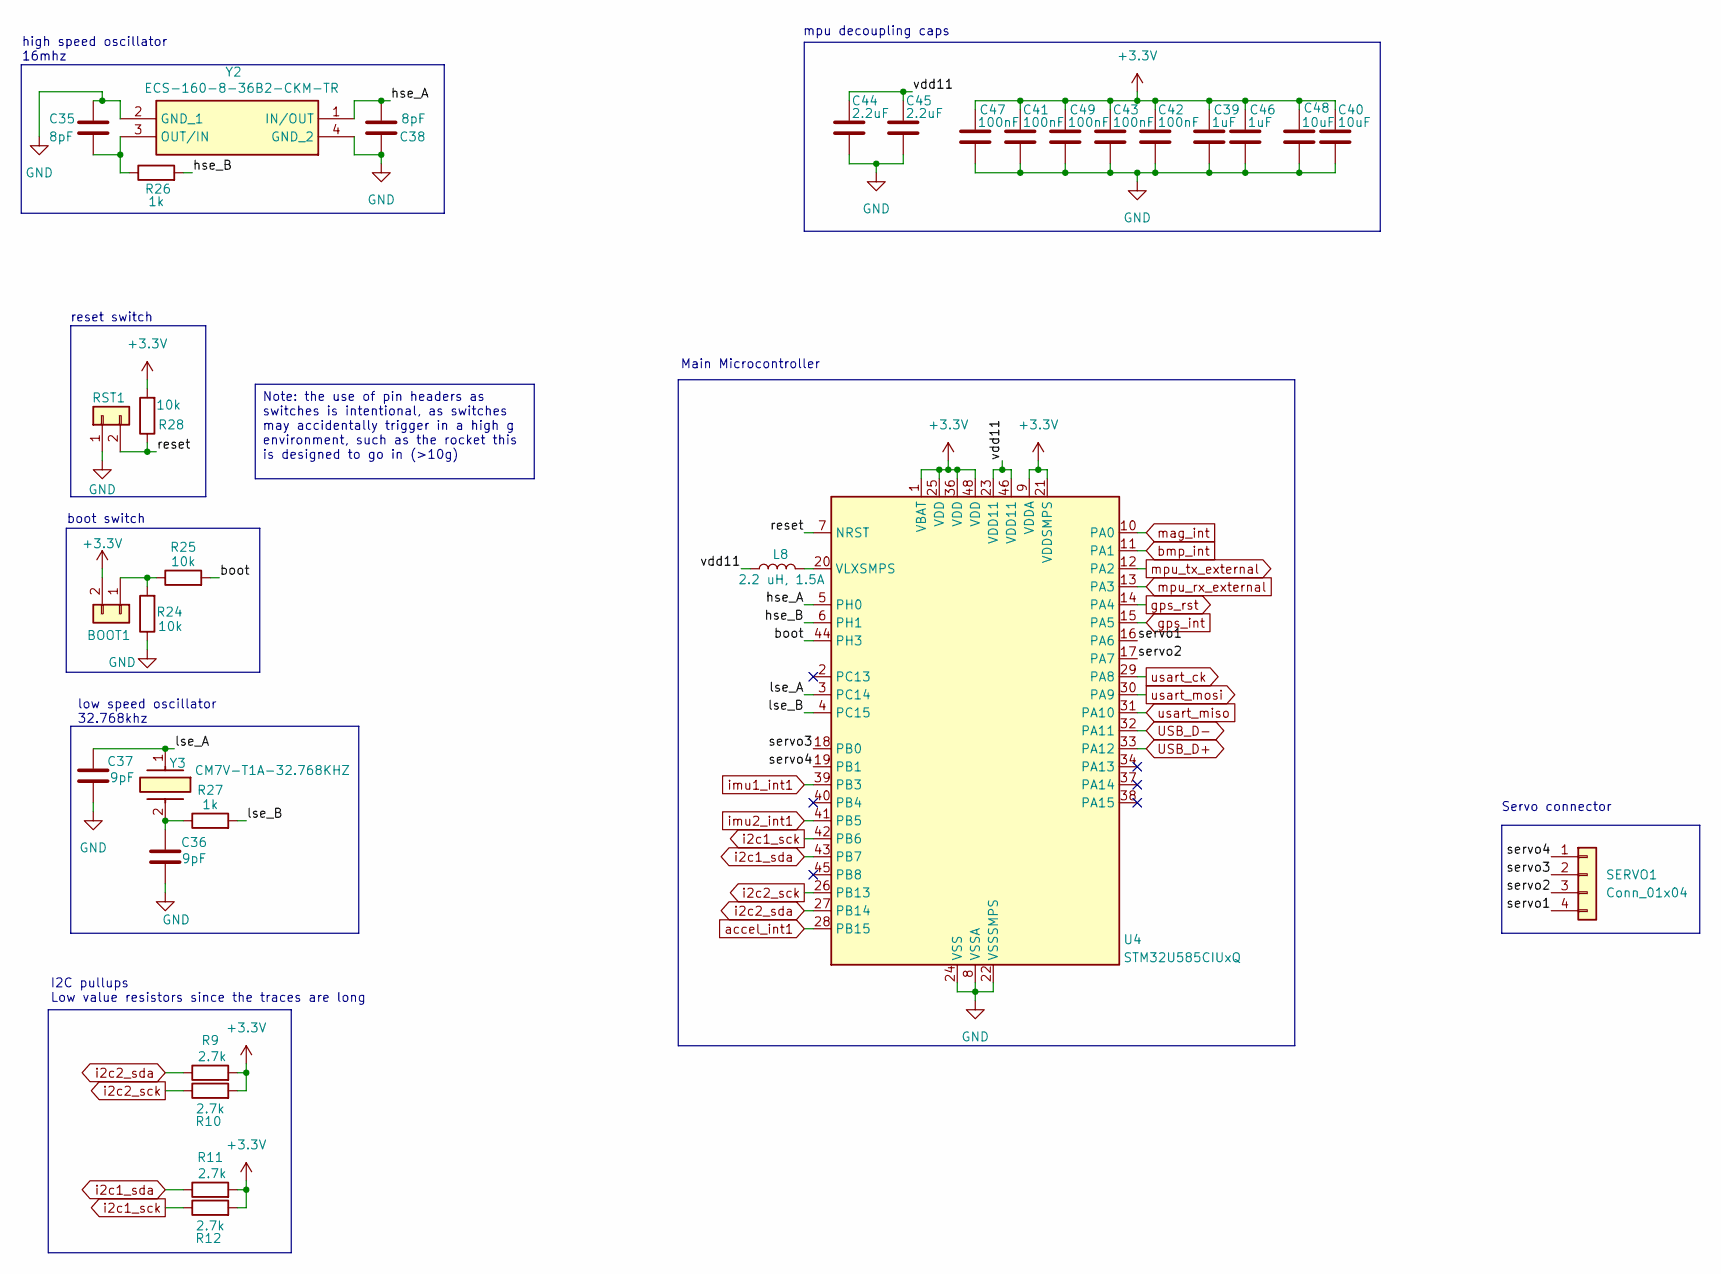
[picture p25: schematic mpu.kicad_sch]

Parts:
BOOT1: Conn_01x02; PinHeader_1x02_P2.54mm_Vertical
C35, C38: 8pF; C_0402_1005Metric
C36, C37: 9pF; C_0402_1005Metric
C39, C46: 1uF; C_0603_1608Metric
C40, C48: 10uF; C_0603_1608Metric
C41, C42, C43, C47, C49: 100nF; C_0402_1005Metric
C44, C45: 2.2uF; C_0603_1608Metric
L8: 2.2 uH, 1.5A; INDC2520X120N
R9, R10, R11, R12: 2.7k; R_0402_1005Metric
R24, R25, R28: 10k; R_0402_1005Metric
R26, R27: 1k; R_0402_1005Metric
RST1: Conn_01x02; PinHeader_1x02_P2.54mm_Vertical
SERVO1: Conn_01x04; TBC05041GG
U4: STM32U585CIUxQ; QFN-48-1EP_7x7mm_P0.5mm_EP5.6x5.6mm
Y2: ECS-160-8-36B2-CKM-TR; ECS160836B2CKMTR; Mouser Part Number 520-160-8-36B2-CKMTR
Y3: CM7V-T1A-32.768KHZ; CM7V32768TBQA020; Mouser Part Number 428-201565-MG01

Connections:
/main micro/boot: R25.2, U4.44 (PH3)
/main micro/hse_A: C38.1, U4.5 (PH0), Y2.1 (IN/OUT)
/main micro/hse_B: R26.2, U4.6 (PH1)
/main micro/lse_A: C37.1, U4.3 (PC14), Y3.1
/main micro/lse_B: R27.2, U4.4 (PC15)
/main micro/reset: R28.1, RST1.2, U4.7 (NRST)
/main micro/servo1: SERVO1.4, U4.16 (PA6)
/main micro/servo2: SERVO1.3, U4.17 (PA7)
/main micro/servo3: SERVO1.2, U4.18 (PB0)
/main micro/servo4: SERVO1.1, U4.19 (PB1)
/main micro/vdd11: C44.1, C45.1, L8.1, U4.23 (VDD11), U4.46 (VDD11)
GND: C35.2, C36.2, C37.2, C38.2, C39.2, C40.2, C41.2, C42.2, C43.2, C44.2, C45.2, C46.2, C47.2, C48.2, C49.2, R24.1, RST1.1, U4.8 (VSSA), U4.22 (VSSSMPS), U4.24 (VSS), U4.35 (VSS), U4.47 (VSS), U4.49 (VSS), Y2.2 (GND_1), Y2.4 (GND_2); also elsewhere on the board
unnamed: BOOT1.1, R24.2, R25.1
unnamed: C36.1, R27.1, Y3.2
unnamed: L8.2, U4.20 (VLXSMPS)
unnamed: C35.1, R26.1, Y2.3 (OUT/IN)
USB_D+: U4.33 (PA12); also elsewhere on the board
USB_D-: U4.32 (PA11); also elsewhere on the board
accel_int1: U4.28 (PB15); also elsewhere on the board
bmp_int: U4.11 (PA1); also elsewhere on the board
gps_int: U4.15 (PA5); also elsewhere on the board
gps_rst: U4.14 (PA4); also elsewhere on the board
i2c1_sck: R12.1, U4.42 (PB6); also elsewhere on the board
i2c1_sda: R11.1, U4.43 (PB7); also elsewhere on the board
i2c2_sck: R10.1, U4.26 (PB13); also elsewhere on the board
i2c2_sda: R9.1, U4.27 (PB14); also elsewhere on the board
imu1_int1: U4.39 (PB3); also elsewhere on the board
imu2_int1: U4.41 (PB5); also elsewhere on the board
mag_int: U4.10 (PA0); also elsewhere on the board
mpu_rx_external: U4.13 (PA3); also elsewhere on the board
mpu_tx_external: U4.12 (PA2); also elsewhere on the board
usart_ck: U4.29 (PA8); also elsewhere on the board
usart_miso: U4.31 (PA10); also elsewhere on the board
usart_mosi: U4.30 (PA9); also elsewhere on the board

Notes on the sheet:
I2C pullups Low value resistors since the traces are long
Main Microcontroller
mpu decoupling caps
Servo connector
high speed oscillator 16mhz
boot switch
reset switch
low speed oscillator 32.768khz
Note: the use of pin headers as switches is intentional, as switches may accidentally trigger in a high g environment, such as the rocket this is designed to go in (>10g)

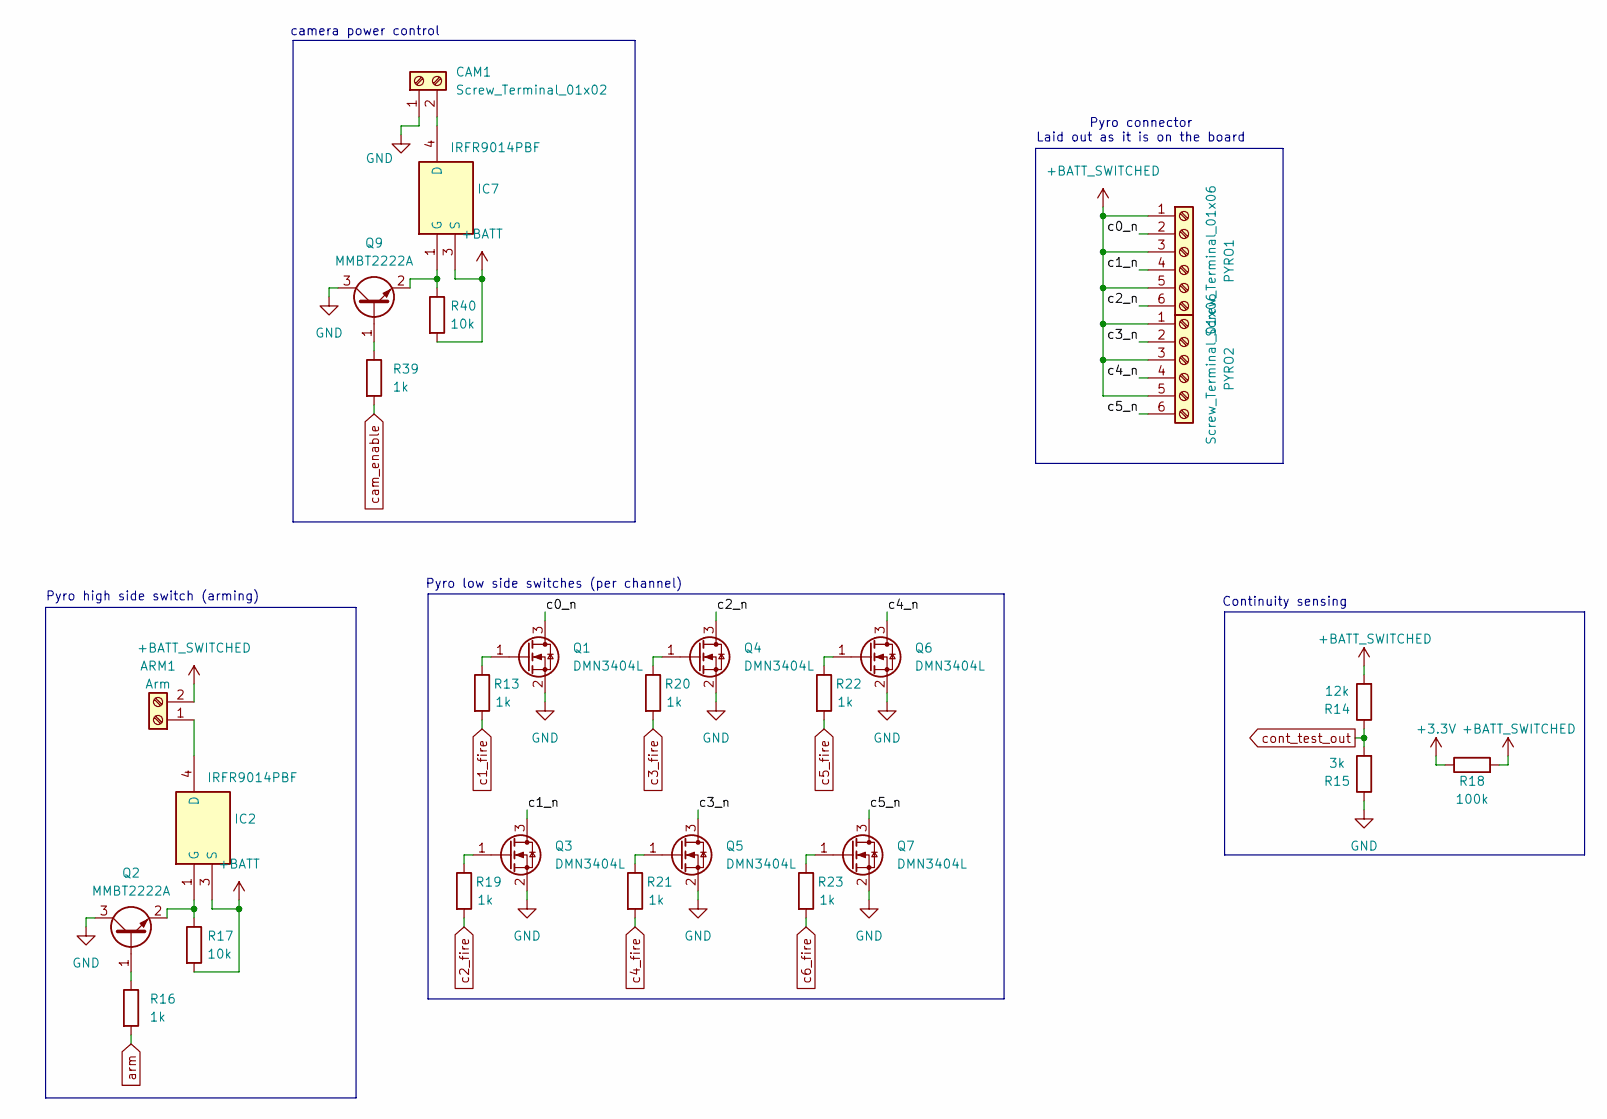
[picture p26: schematic mosfets.kicad_sch]

Parts:
ARM1: Arm; TBC05021GG
CAM1: Screw_Terminal_01x02; TBC05021GG
IC2, IC7: IRFR9014PBF; TO228P990X238-3N; Mouser Part Number 844-IRFR9014PBF
PYRO1, PYRO2: Screw_Terminal_01x06; TBC05061GG
Q1, Q3, Q4, Q5, Q6, Q7: DMN3404L; SOT-23
Q2, Q9: MMBT2222A; SOT-23
R13, R16, R19, R20, R21, R22, R23, R39: 1k; R_0402_1005Metric
R14: 12k; R_0402_1005Metric
R15: 3k; R_0402_1005Metric
R17, R40: 10k; R_0402_1005Metric
R18: 100k; R_0402_1005Metric

Connections:
+BATT: IC2.3 (S), IC7.3 (S), R17.2, R40.2; also elsewhere on the board
+BATT_SWITCHED: ARM1.2, PYRO1.1, PYRO1.3, PYRO1.5, PYRO2.1, PYRO2.3, PYRO2.5, R14.2, R18.2
/mosfets/c0_n: PYRO1.2, Q1.3 (D)
/mosfets/c1_n: PYRO1.4, Q3.3 (D)
/mosfets/c2_n: PYRO1.6, Q4.3 (D)
/mosfets/c3_n: PYRO2.2, Q5.3 (D)
/mosfets/c4_n: PYRO2.4, Q6.3 (D)
/mosfets/c5_n: PYRO2.6, Q7.3 (D)
GND: CAM1.1, Q1.2 (S), Q2.3 (C), Q3.2 (S), Q4.2 (S), Q5.2 (S), Q6.2 (S), Q7.2 (S), Q9.3 (C), R15.1; also elsewhere on the board
unnamed: ARM1.1, IC2.4 (D)
unnamed: CAM1.2, IC7.4 (D)
unnamed: IC2.1 (G), Q2.2 (E), R17.1
unnamed: IC7.1 (G), Q9.2 (E), R40.1
unnamed: Q1.1 (G), R13.1
unnamed: Q2.1 (B), R16.1
unnamed: Q3.1 (G), R19.1
unnamed: Q4.1 (G), R20.1
unnamed: Q5.1 (G), R21.1
unnamed: Q6.1 (G), R22.1
unnamed: Q7.1 (G), R23.1
unnamed: Q9.1 (B), R39.1
arm: R16.2; also elsewhere on the board
c1_fire: R13.2; also elsewhere on the board
c2_fire: R19.2; also elsewhere on the board
c3_fire: R20.2; also elsewhere on the board
c4_fire: R21.2; also elsewhere on the board
c5_fire: R22.2; also elsewhere on the board
c6_fire: R23.2; also elsewhere on the board
cam_enable: R39.2; also elsewhere on the board
cont_test_out: R14.1, R15.2; also elsewhere on the board

Notes on the sheet:
camera power control
Pyro low side switches (per channel)
Pyro high side switch (arming)
Continuity sensing
Pyro connector Laid out as it is on the board

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
