electricboy6/STM32U585-devboard/pcb/stDevboard.kicad_pcb

## KiCad design pcb/stDevboard.kicad_pcb (continued)

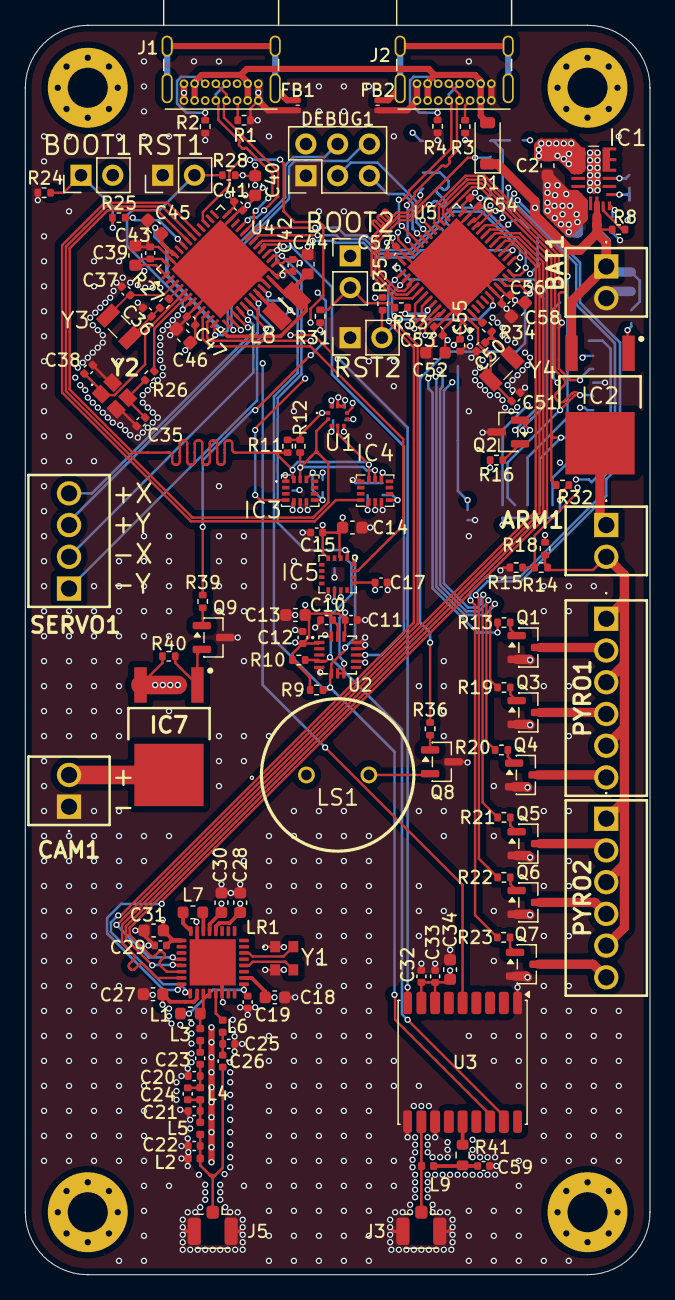
[picture p27: board stDevboard.kicad_pcb from above]

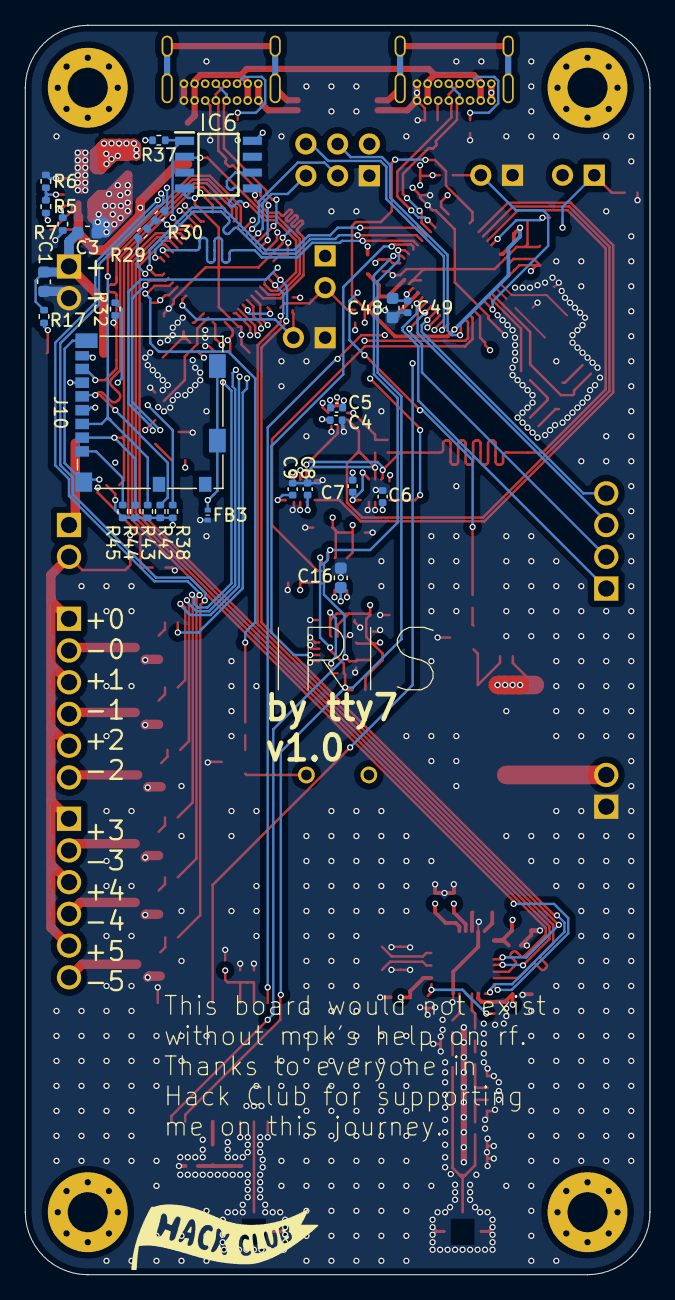
[picture p28: board stDevboard.kicad_pcb from below]

Board: 4 copper layers, 50.0 x 100.0 mm, 161 parts (27 on the bottom side), 122 nets.

Other parts of the board:
R32#2: 10k; R_0402_1005Metric
