electricboy6/STM32U585-devboard/firmware/ppu/src/pins.cpp

#include "pins.h"

void pins::init() {
    SerialUSB.begin(1000000); // 1 mbaud
    while(!SerialUSB.available()) {}

    interconnectSerial.begin(250000, SERIAL_8E1); // 250 kbaud, even parity
    while(!interconnectSerial.available()) {}

    debugSerial.begin(115200); // 115.2 kbaud, standard

    // mode 0, 16mhz
    telem.beginTransaction(SPISettings(16000000, MSBFIRST, SPI_MODE0));

    // mode 0, 32mhz - max supported speed (flash goes up to 55mhz)
    flash.beginTransaction(SPISettings(32000000, MSBFIRST, SPI_MODE0));

    //sd.beginTransaction(SPISettings(25000000, MSBFIRST, SPI_MODE0));
    
    // 12 bit analog reads
    analogReadResolution(12);

    // all pinModes
    pinMode(pins::vbat, INPUT_ANALOG);

    pinMode(pins::flash_cs, OUTPUT);

    pinMode(pins::telem_cs, OUTPUT);
    pinMode(pins::telem_busy, INPUT_FLOATING);
    pinMode(pins::telem_rst, OUTPUT);

    pinMode(pins::arm, OUTPUT);
    pinMode(pins::c0_fire, OUTPUT);
    pinMode(pins::c1_fire, OUTPUT);
    pinMode(pins::c2_fire, OUTPUT);
    pinMode(pins::c3_fire, OUTPUT);
    pinMode(pins::c4_fire, OUTPUT);
    pinMode(pins::c5_fire, OUTPUT);
    pinMode(pins::cont_test, INPUT_ANALOG);

    pinMode(pins::piezo, OUTPUT);
}
