electricboy6/STM32U585-devboard/firmware/ppu/FC_PPU/variant_FC_PPU.cpp

#include "pins_arduino.h"

#ifdef __cplusplus
extern "C" {
#endif

// pin defs
const PinName digitalPin[] = {
    PA_0,
    PA_1,
    PA_2,
    PA_3,
    PA_4,
    PA_5,
    PA_6,
    PA_7,
    PA_8,
    PA_9,
    PA_10,
    PA_11,
    PA_12,
    PA_13,
    PA_14,
    PA_15,
    PB_0,
    PB_1,
    PB_2,
    PB_3,
    PB_4,
    PB_5,
    PB_6,
    PB_7,
    PB_8,
    PB_9,
    PB_10,
    PB_11,
    PB_12,
    PB_13,
    PB_14,
    PB_15
};

const uint32_t analogInputPin[] = {
    11, // PA1, continuity
    19, // PB1, vbat
};

#ifdef __cplusplus
}
#endif

// clock config
#ifdef __cplusplus
extern "C" {
#endif

// generated by cubemx
WEAK void SystemClock_Config(void)
{
  RCC_OscInitTypeDef RCC_OscInitStruct = {0};
  RCC_ClkInitTypeDef RCC_ClkInitStruct = {0};

  /** Configure the main internal regulator output voltage
  */
  HAL_PWREx_ControlVoltageScaling(PWR_REGULATOR_VOLTAGE_SCALE1);

  /** Initializes the RCC Oscillators according to the specified parameters
  * in the RCC_OscInitTypeDef structure.
  */
  RCC_OscInitStruct.OscillatorType = RCC_OSCILLATORTYPE_HSI|RCC_OSCILLATORTYPE_HSI48;
  RCC_OscInitStruct.HSIState = RCC_HSI_ON;
  RCC_OscInitStruct.HSICalibrationValue = RCC_HSICALIBRATION_DEFAULT;
  RCC_OscInitStruct.HSI48State = RCC_HSI48_ON;
  RCC_OscInitStruct.PLL.PLLState = RCC_PLL_ON;
  RCC_OscInitStruct.PLL.PLLSource = RCC_PLLSOURCE_HSI;
  RCC_OscInitStruct.PLL.PLLM = RCC_PLLM_DIV1;
  RCC_OscInitStruct.PLL.PLLN = 7;
  RCC_OscInitStruct.PLL.PLLP = RCC_PLLP_DIV2;
  RCC_OscInitStruct.PLL.PLLQ = RCC_PLLQ_DIV2;
  RCC_OscInitStruct.PLL.PLLR = RCC_PLLR_DIV2;
  if (HAL_RCC_OscConfig(&RCC_OscInitStruct) != HAL_OK)
  {
    Error_Handler();
  }

  /** Initializes the CPU, AHB and APB buses clocks
  */
  RCC_ClkInitStruct.ClockType = RCC_CLOCKTYPE_HCLK|RCC_CLOCKTYPE_SYSCLK
                              |RCC_CLOCKTYPE_PCLK1;
  RCC_ClkInitStruct.SYSCLKSource = RCC_SYSCLKSOURCE_PLLCLK;
  RCC_ClkInitStruct.AHBCLKDivider = RCC_SYSCLK_DIV1;
  RCC_ClkInitStruct.APB1CLKDivider = RCC_HCLK_DIV1;

  if (HAL_RCC_ClockConfig(&RCC_ClkInitStruct, FLASH_LATENCY_2) != HAL_OK)
  {
    Error_Handler();
  }
}

#ifdef __cplusplus
}
#endif
