electricboy6/STM32U585-devboard/firmware/mpu/board_def/variant.h

#ifndef _VARIANT_ARDUINO_STM32_
#define _VARIANT_ARDUINO_STM32_

#ifdef __cplusplus
extern "C" {
#endif

// Pin defs
#define PA0 // todo
// good resource: https://community.platformio.org/t/use-arduino-framework-for-a-custom-stm32-board/14586/4
