electricboy6/STM32U585-devboard/(commit log)

2025-10-13 worked on schematic
    [stDevboard.kicad_sch]
2025-10-14 worked some more on schematic, also figured out more of oscillator stuff and boot button
    [stDevboard.kicad_pcb, stDevboard.kicad_sch]
2025-10-23 worked on a ton of stuff, see journal for details
    [stDevboard.kicad_pcb, stDevboard.kicad_sch]
2025-10-23 added libs
    [BMP581.PcbLib, BMP581.SchLib, BMP581.stp, EDI2CAP.CFG, ICM-42670-P.stp, MMC5603NJ.PcbLib, MMC5603NJ.SchLib, MMC5603NJ.stp]
2025-10-23 added new schematic
    [mosfets.kicad_sch]
2025-10-26 everything I did while on vacation - initial schematic finished, footprints mostly assigned, and pcb layout started
    [EDI2CAP.CFG, INDC2520X120N.PcbLib, KTS1622EUAA-TR.SchLib, KTS1622EUAA-TR.stp, MAMK2520H2R2M.SchLib, MAMK2520H2R2M.stp, MAX-F10S-00B.SchLib, MAX-F10S-00B.stp]
2025-10-27 pcb coming along, schematic way more done - I now have a lot more respect for hardware people than I did earlier
    [mosfets.kicad_sch, sensors.kicad_sch, stDevboard.kicad_pcb, stDevboard.kicad_sch]
2025-11-10 tons of work, see journal for details
    [ECS-TXO-25CSMV-320-AM-TR.SchLib, ECS-TXO-25CSMV-320-AM-TR.stp, ECSTXO25CSMV320AMTR.PcbLib, EDI2CAP.CFG, IRFR9014PBF.stp, MAX-F10S-00B.SchLib, MAX-F10S-00B.stp, MAXF10S00B.PcbLib]
2025-11-26 oops forgot to commit - looks like I worked on the lr2021's symbol and the schematic - see journal for details on what I did
    [ECS-160-8-36B2-CKM-TR.SchLib, ECS-160-8-36B2-CKM-TR.stp, ECS160836B2CKMTR.PcbLib, EDI2CAP.CFG, chips.prt, ecs160836b2ckmtr.psm, rf.kicad_sch, stDevboard.kicad_sch]
2025-11-30 tons of progress on schematic and pcb - see journal for details
    [BLM15AX102SN1D.stp, CM7V-T1A-32.768KHZ-9PF-10PPM-TA-QC.stp, EDI2CAP.CFG, chips.prt, cm7v32768tbqa020.psm, mosfets.kicad_sch, mpu.kicad_sch, nfz15sg152sn10b.psm]
2025-11-30 added mounting holes, moved power stuff, routed secondary micro, moved sensors
    [stDevboard.kicad_pcb]
2025-12-02 worked mainly on pcb
    [73412-0110.psm, 73412-0114.stp, EDI2CAP.CFG, chips.prt, mosfets.kicad_sch, mpu.kicad_sch, rf.kicad_sch, sensors.kicad_sch]
2025-12-02 basically just decoupling capacitors that I forgot
    [mpu.kicad_sch, rf.kicad_sch, sensors.kicad_sch, stDevboard.kicad_pcb]
2025-12-04 worked on adding mosfet stuff, last of the major signal traces routed
    [mosfets.kicad_sch, stDevboard.kicad_pcb, stDevboard.kicad_sch]
2025-12-07 added in the flash chip and micro sd card, rerouted some stuff, looking real nice rn - still need to finish rf, pyros, and add in the piezo
    [AT25SF041B-SSHB-B.SchLib, AT25SF041B-SSHB-B.stp, EDI2CAP.CFG, SOIC127P600X175-8N.PcbLib, chips.prt, ppu.kicad_sch, rf.kicad_sch, soic127p600x175-8n.psm]
2025-12-08 added piezo buzzer, rf hopefully finished! just need to send to mpk for check now
    [EDI2CAP.CFG, PS1240P02BT.stp, chips.prt, ppu.kicad_sch, ps1240p02bt.psm, stDevboard.kicad_pcb, stDevboard.kicad_sch]
2025-12-10 mosfet schematic done I hope
    [mosfets.kicad_sch, ppu.kicad_sch, stDevboard.kicad_pcb]
2025-12-10 mosfet schematic should be finalized
    [mosfets.kicad_sch]
2025-12-10 placed mosfet stuff, probably all that's left is add pull resistors on the nfets and finish routing the fets
    [mosfets.kicad_sch, stDevboard.kicad_pcb]
2025-12-11 idk what I did but it wasn't saved
    [mosfets.kicad_sch, stDevboard.kicad_pcb, stDevboard.kicad_sch]
2025-12-13 almost done routing! getting pretty close to done now
    [mpu.kicad_sch, ppu.kicad_sch, rf.kicad_sch, stDevboard.kicad_pcb]
2025-12-13 routing done! silkscreen is probably good enough for now
    [stDevboard.kicad_pcb]
2025-12-14 stiching and fencing vias, fixed via diameters
    [stDevboard.kicad_pcb]
2025-12-15 added decoupling caps, added high g accel - about to redo basically all of the pin allocations on the mpu so I can have a high speed and low speed i2c
    [sensors.kicad_sch]
2025-12-19 schematic updated - need to redo the layout now
    [H3LIS331DLTR.step, mpu.kicad_sch, rf.kicad_sch, stDevboard.kicad_pcb]
2025-12-19 started redoing layout for new pinout
    [mpu.kicad_sch, rf.kicad_sch, sensors.kicad_sch, stDevboard.kicad_pcb]
2025-12-19 finished the reroute - just need to redo silkscreen and verify everything
    [ppu.kicad_sch, stDevboard.kicad_pcb]
2025-12-19 restructured repo
    [73412-0110.psm, 73412-0114.stp, AT25SF041B-SSHB-B.SchLib, AT25SF041B-SSHB-B.stp, BLM15AX102SN1D.stp, BMP581.PcbLib, BMP581.SchLib, BMP581.stp]
2025-12-20 rerouted oscillator stuff - still need to finish i2c routing, also started a platformio board definition
    [mpu.kicad_sch, stDevboard.kicad_pcb]
2025-12-20 fixed some stuff with board def
    [variant_FC_MPU.h]
2025-12-20 reroute done! except for the gps which I'm currently verifying my implementation on
    [rf.kicad_sch, stDevboard.kicad_pcb]
2025-12-20 board def hopefully done, mpu test firmware written
    [mpu.kicad_sch, stDevboard.kicad_pcb, stDevboard.kicad_sch]
2025-12-21 added models for some things, fixed micro sd impl and a bunch of other stuff - pcb currently probably ready for production
    [MAX-M10S-00B.STEP, mosfets.kicad_sch, mpu.kicad_sch, ppu.kicad_sch, rf.kicad_sch, sensors.kicad_sch, stDevboard.kicad_pcb, stDevboard.kicad_sch]
2025-12-21 start of ppu firmware
    [ppu.kicad_sch]
2025-12-21 started making bom - changed some stuff for compatibility with it
    [KTS1622EUAA-TR.stp, mpu.kicad_sch, sensors.kicad_sch, stDevboard.kicad_pcb, stDevboard.kicad_sch]
2025-12-22 lots of work on ppu firmware, especially relating to flash - also corrected some schematic errors (haven't gotten around to updating pcb yet)
    [ppu.kicad_sch]
2025-12-22 updated pcb from schematic changes, also added some length tuning because why not
    [mosfets.kicad_sch, mpu.kicad_sch, stDevboard.kicad_pcb, stDevboard.kicad_sch]
2025-12-22 flash driver done, started littlefs integration - only the header and the hal functions done so far, still need to write the wrappers
2025-12-23 mainly worked on bom (still just on google sheets), but while doing so fixed some issues and redid some component selection
    [TBC05-02-1-G-G.stp, TBC05-04-1-G-G.stp, TBC05-06-1-G-G.stp, mosfets.kicad_sch, mpu.kicad_sch, rf.kicad_sch, stDevboard.kicad_pcb, stDevboard.kicad_sch]
2025-12-23 added bom
    [bom.csv]
2025-12-23 oops had extra rows in bom, fixed now
    [bom.csv]
2025-12-26 reorganized schematic, started to add a readme (not really though), also pcb updated
    [mosfets.kicad_sch, mpu.kicad_sch, ppu.kicad_sch, rf.kicad_sch, sensors.kicad_sch, stDevboard.kicad_pcb, stDevboard.kicad_sch]
2025-12-26 added camera high side switching
    [mosfets.kicad_sch, ppu.kicad_sch, stDevboard.kicad_pcb]
2025-12-26 modified gps for an active antenna
    [mpu.kicad_sch, rf.kicad_sch, stDevboard.kicad_pcb]
2025-12-26 fixed up silkscreen a bit
    [stDevboard.kicad_pcb]
2025-12-27 fixed micro sd pullups
    [ppu.kicad_sch, sensors.kicad_sch, stDevboard.kicad_pcb]
2025-12-27 yay added 3d models for some missing parts
    [1040310811.stp, stDevboard.kicad_pcb, tbc05-04-1-g-g.stp, tbc05-06-1-g-g.stp]
2025-12-29 fixed vr_pa trace impedance (thanks mpk)
    [stDevboard.kicad_pcb]
2025-12-29 YAY pictures in readme, just need to update BoM and submit!
2025-12-31 bom finalized
    [bom.csv]
2025-12-31 added gerbers
    [IRIS_V1_bom.csv, IRIS_V1_designators.csv, IRIS_V1_positions.csv, bom.csv, designators.csv, positions.csv]
2025-12-31 added bom to readme, fab options
2026-01-01 updated bom for new flash chip
    [bom.csv]
2026-01-02 added silkscreen art and credits
    [stDevboard.kicad_pcb]
2026-01-03 updated gerbers, missing files
    [IRIS_V1_designators.csv, bom.csv, designators.csv, positions.csv]
2026-01-04 hopefully clarified bom
    [bom.csv]
2026-01-04 made bom more readable again
    [bom.csv]
2026-01-11 final gerber that was produced
2026-01-24 add a section for any issues found
    oops those 22uf caps are rated for 6.3v and they should be more of 25v rated oh well it doesn't really matter
