electricboy6/STM32U585-devboard/(notices)

Notices in the files:
pcb/partsLibs/TBC05-02-1-G-G/3D/TBC05-02-1-G-G.stp:
author */ ('License CC BY-ND 4.0'),
